fabrilabdesign/Yirra-docs/yirra_docs/docs/downloads.mdx

---
sidebar_position: 1
title: CAD Downloads
---

import { ModelViewer } from '@site/src/components/ModelViewer';
import DownloadGate from '@site/src/components/DownloadGate';

# CAD Downloads

Download all files needed to build your Replicant GEN 1 drone platform.

:::tip 🎯 First Time Builder?
**Skip the custom parts hunting** — Get our **Replicant Release Bundle** with all Yirra-manufactured components (carbon plates, battery, PMB, and fasteners) in one package. Off-the-shelf electronics sourced separately.

<a href="https://yirrasystems.com/product/prod_TqcqCXEB6vE8m6" target="_blank" rel="noopener noreferrer" style={{ display: 'inline-flex', alignItems: 'center', gap: '8px', padding: '10px 20px', backgroundColor: '#3b82f6', color: 'white', borderRadius: '8px', textDecoration: 'none', fontWeight: '500', marginTop: '8px' }}>
  🛒 View Release Bundle ($369 AUD)
</a>
:::

<ModelViewer
  modelPath="/files/3d-models/Replicant_Gen1.glb"
  title="Replicant GEN 1"
  description="Complete drone assembly"
  height="450px"
  showWireframeToggle={true}
  showFullscreenToggle={true}
  autoRotate={true}
/>

---

## Quick Downloads

Get everything you need in one click.

<div style={{ display: 'flex', gap: '16px', flexWrap: 'wrap', margin: '24px 0' }}>
  <DownloadGate file="/files/3d-printing/stl/Replicant_gen1_STL.zip" category="stl_zip" label="Download All STL Files (ZIP)" icon="📦" />
  <DownloadGate file="/files/STEP_Files/Replicant_gen1_STEP.zip" category="step_zip" label="Download All STEP Files (ZIP)" icon="📐" />
  <DownloadGate file="/files/3d-printing/stl/replicant_gen_1.stl" category="stl" label="Complete Assembly STL" icon="🖨️" />
  <DownloadGate file="/files/STEP_Files/Replicant_gen1.stp" category="step" label="Complete Assembly STEP" icon="📐" />
</div>

---

## 3MF project files

3MF packages with print settings, supports, and orientations (authored in Bambu Studio; import into PrusaSlicer, OrcaSlicer, or your slicer of choice). For printer guidance and ethics, see [3D Printing](/docs/3d-printing#equipment-considerations).

<table>
  <thead>
    <tr><th>Component</th><th>Description</th><th>Download</th></tr>
  </thead>
  <tbody>
    <tr>
      <td><strong>Chassis Core (Left USB)</strong></td>
      <td>Main structural component - USB port on left</td>
      <td><DownloadGate file="/files/3d-printing/3mf/Chassis_core_left_USB_modi.gcode.3mf" category="3mf" label="Download 3MF" icon="⬇" /></td>
    </tr>
    <tr>
      <td><strong>Chassis Core (Right USB)</strong></td>
      <td>Main structural component - USB port on right</td>
      <td><DownloadGate file="/files/3d-printing/3mf/Chassis_core_right_USB_modi.gcode.3mf" category="3mf" label="Download 3MF" icon="⬇" /></td>
    </tr>
    <tr>
      <td><strong>Arm Bosses</strong></td>
      <td>All four arm mounting interfaces</td>
      <td><DownloadGate file="/files/3d-printing/3mf/Arm_bosses.gcode.3mf" category="3mf" label="Download 3MF" icon="⬇" /></td>
    </tr>
    <tr>
      <td><strong>Motor Mounts</strong></td>
      <td>High-strength motor mounting brackets</td>
      <td><DownloadGate file="/files/3d-printing/3mf/Motor_mounts.gcode.3mf" category="3mf" label="Download 3MF" icon="⬇" /></td>
    </tr>
    <tr>
      <td><strong>Nose Cone 04 Mount</strong></td>
      <td>Camera and antenna mounting component</td>
      <td><DownloadGate file="/files/3d-printing/3mf/Nose_cone_04_mount.gcode.3mf" category="3mf" label="Download 3MF" icon="⬇" /></td>
    </tr>
    <tr>
      <td><strong>Battery Rail Male</strong></td>
      <td>Battery mounting rail component</td>
      <td><DownloadGate file="/files/3d-printing/3mf/Battery_rail_male.gcode.3mf" category="3mf" label="Download 3MF" icon="⬇" /></td>
    </tr>
  </tbody>
</table>

---

## Individual Component Files

Need specific parts? Expand the sections below to download individual components.

<details>
<summary><strong>STEP Files (Editable CAD)</strong></summary>

Full parametric models for CAD modification and custom adaptations.

<table>
  <thead><tr><th>Component</th><th>Download</th></tr></thead>
  <tbody>
    <tr><td>Chassis Core Left USB</td><td><DownloadGate file="/files/STEP_Files/chassis_core_left_usb.stp" category="step" label="Download STEP" icon="⬇" /></td></tr>
    <tr><td>Chassis Core Right USB</td><td><DownloadGate file="/files/STEP_Files/chassis_core_right_usb.stp" category="step" label="Download STEP" icon="⬇" /></td></tr>
    <tr><td>Motor Mount</td><td><DownloadGate file="/files/STEP_Files/Motor_mount.stp" category="step" label="Download STEP" icon="⬇" /></td></tr>
    <tr><td>Battery Rail Male</td><td><DownloadGate file="/files/STEP_Files/battery_rail_male.stp" category="step" label="Download STEP" icon="⬇" /></td></tr>
    <tr><td>Front Left Arm Boss</td><td><DownloadGate file="/files/STEP_Files/Left_front_arm_boss.stp" category="step" label="Download STEP" icon="⬇" /></td></tr>
    <tr><td>Front Right Arm Boss</td><td><DownloadGate file="/files/STEP_Files/Right_front_arm_boss.stp" category="step" label="Download STEP" icon="⬇" /></td></tr>
    <tr><td>Rear Left Arm Boss</td><td><DownloadGate file="/files/STEP_Files/Left_rear_arm_boss.stp" category="step" label="Download STEP" icon="⬇" /></td></tr>
    <tr><td>Rear Right Arm Boss</td><td><DownloadGate file="/files/STEP_Files/Right_rear_arm_boss.stp" category="step" label="Download STEP" icon="⬇" /></td></tr>
    <tr><td>Upper Shell</td><td><DownloadGate file="/files/STEP_Files/upper_shell.stp" category="step" label="Download STEP" icon="⬇" /></td></tr>
    <tr><td>04cm Component</td><td><DownloadGate file="/files/STEP_Files/04cm.stp" category="step" label="Download STEP" icon="⬇" /></td></tr>
    <tr><td>Spine</td><td><DownloadGate file="/files/STEP_Files/spine.stp" category="step" label="Download STEP" icon="⬇" /></td></tr>
    <tr><td>Top Plate Brace</td><td><DownloadGate file="/files/STEP_Files/top_plate_brace.stp" category="step" label="Download STEP" icon="⬇" /></td></tr>
    <tr><td>Bottom Plate</td><td><DownloadGate file="/files/STEP_Files/bottom_plate.stp" category="step" label="Download STEP" icon="⬇" /></td></tr>
  </tbody>
</table>

</details>

<details>
<summary><strong>STL Files (Mesh for Slicers)</strong></summary>

Mesh files for 3D printing with any slicer software.

<table>
  <thead><tr><th>Component</th><th>Download</th></tr></thead>
  <tbody>
    <tr><td>Chassis Core Left USB</td><td><DownloadGate file="/files/3d-printing/stl/chassis_core_left_usb.stl" category="stl" label="Download STL" icon="⬇" /></td></tr>
    <tr><td>Chassis Core Right USB</td><td><DownloadGate file="/files/3d-printing/stl/chassis_core_right_usb.stl" category="stl" label="Download STL" icon="⬇" /></td></tr>
    <tr><td>Motor Mounts</td><td><DownloadGate file="/files/3d-printing/stl/motor_mounts.stl" category="stl" label="Download STL" icon="⬇" /></td></tr>
    <tr><td>Left Front Arm Boss</td><td><DownloadGate file="/files/3d-printing/stl/left_front_armboss.stl" category="stl" label="Download STL" icon="⬇" /></td></tr>
    <tr><td>Right Front Arm Boss</td><td><DownloadGate file="/files/3d-printing/stl/right_front_arm_boss.stl" category="stl" label="Download STL" icon="⬇" /></td></tr>
    <tr><td>Left Rear Arm Boss</td><td><DownloadGate file="/files/3d-printing/stl/left_rear_arm_boss.stl" category="stl" label="Download STL" icon="⬇" /></td></tr>
    <tr><td>Right Rear Arm Boss</td><td><DownloadGate file="/files/3d-printing/stl/right_rear_arm_boss.stl" category="stl" label="Download STL" icon="⬇" /></td></tr>
    <tr><td>Battery Rail Male</td><td><DownloadGate file="/files/3d-printing/stl/battery_rail_male.stl" category="stl" label="Download STL" icon="⬇" /></td></tr>
    <tr><td>Upper Shell</td><td><DownloadGate file="/files/3d-printing/stl/upper_shell.stl" category="stl" label="Download STL" icon="⬇" /></td></tr>
    <tr><td>Spine</td><td><DownloadGate file="/files/3d-printing/stl/spine.stl" category="stl" label="Download STL" icon="⬇" /></td></tr>
    <tr><td>Top Plate Brace</td><td><DownloadGate file="/files/3d-printing/stl/top_plate_brace.stl" category="stl" label="Download STL" icon="⬇" /></td></tr>
    <tr><td>Bottom Plate</td><td><DownloadGate file="/files/3d-printing/stl/bottom_plate.stl" category="stl" label="Download STL" icon="⬇" /></td></tr>
    <tr><td>04cm Mount</td><td><DownloadGate file="/files/3d-printing/stl/04cm.stl" category="stl" label="Download STL" icon="⬇" /></td></tr>
  </tbody>
</table>

</details>

---

## Revision History

<div style={{ fontFamily: 'ui-monospace, SFMono-Regular, Menlo, Monaco, Consolas, monospace', fontSize: '13px' }}>

<div style={{ border: '1px solid #4b5563' }}>
  <div style={{ backgroundColor: '#1f2937', color: '#f9fafb', padding: '10px 14px', display: 'flex', justifyContent: 'space-between', alignItems: 'center' }}>
    <span style={{ fontWeight: '600', letterSpacing: '0.5px' }}>REV 1.0.0</span>
    <span style={{ color: '#d1d5db' }}>2026-01-22</span>
  </div>
  <div style={{ padding: '14px', backgroundColor: '#111827' }}>
    <div style={{ display: 'grid', gridTemplateColumns: '70px 1fr', gap: '6px 12px', lineHeight: '1.7' }}>
      <span style={{ color: '#34d399', fontWeight: '600' }}>[INIT]</span><span style={{ color: '#e5e7eb' }}>Initial release — Replicant GEN 1 CAD package</span>
      <span style={{ color: '#9ca3af', fontWeight: '500' }}>[INC]</span><span style={{ color: '#d1d5db' }}>3MF print projects (import/migrate settings to your slicer)</span>
      <span style={{ color: '#9ca3af', fontWeight: '500' }}>[INC]</span><span style={{ color: '#d1d5db' }}>STEP files for CAD modification and custom adaptations</span>
      <span style={{ color: '#9ca3af', fontWeight: '500' }}>[INC]</span><span style={{ color: '#d1d5db' }}>STL mesh files for all printable components</span>
      <span style={{ color: '#9ca3af', fontWeight: '500' }}>[INC]</span><span style={{ color: '#d1d5db' }}>Left/Right USB chassis variants</span>
    </div>
  </div>
</div>

</div>

:::info Revision Control
Files follow semantic versioning. Check back for updates after major revisions.
:::

---

## Next Steps

1. [Parts List](/docs/bom) - Get electronics and carbon fiber
2. [3D Printing](/docs/3d-printing) - Proper material handling
3. [Arm Bonding](/docs/arm-bonding) - Start assembly
