fabrilabdesign/Yirra-docs/yirra_docs/docs/platform.md

---
sidebar_position: 1
title: Platform Overview
---

import ImageToggle from '@site/src/components/ImageToggle';
import SupplementalLipoBracketCta from '@site/src/components/SupplementalLipoBracketCta';
import CommercialProgramsPipeline from '@site/src/components/CommercialProgramsPipeline';

# Replicant GEN 1 Platform

Replicant GEN 1 is a long-range FPV platform built around true 3D structural design: carbon-fiber tubes for arm stiffness, volumetric 3D-printed nodes for real load paths, and an enclosed aerodynamic chassis that treats packaging as part of performance. The result is a lighter, stiffer airframe with cleaner airflow, protected electronics, rapid battery swaps, and footage-first vibration control — designed for builders.

---

## Highlights

- **True 3D tubular arms** → truss-level rigidity with cleaner aerodynamics
- **Rail-mounted battery** → fast, repeatable swaps + mass damping for stable footage
- **Intelligent power button + full enclosure** → safer, cleaner operation with protected internals

<picture>
  <source
    type="image/webp"
    srcSet="/img/hero/new_hero_800.webp 800w, /img/hero/new_hero_1200.webp 1200w, /img/hero/new_hero_2400.webp 2400w"
    sizes="(max-width: 800px) 100vw, (max-width: 1400px) 90vw, 1400px"
  />
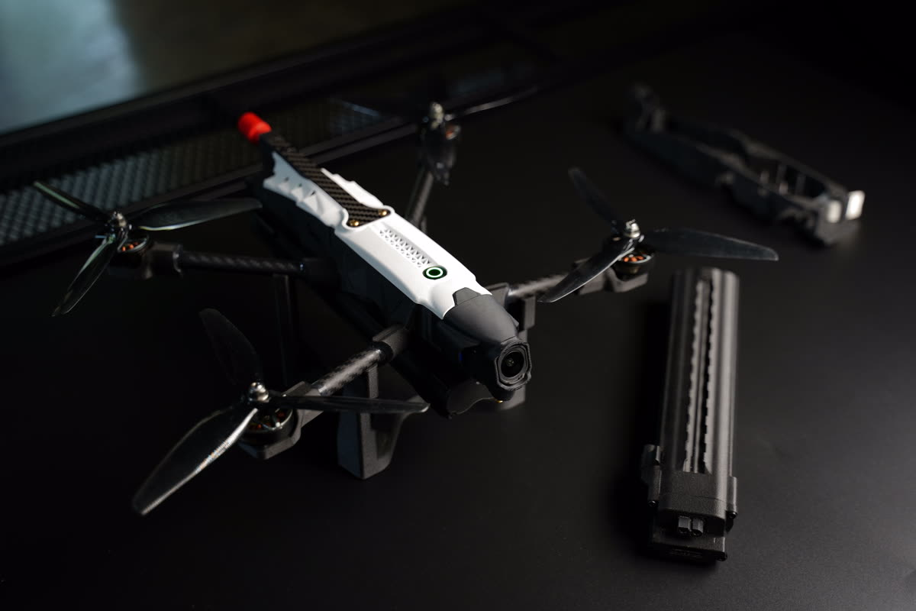
[picture p1: yirra_docs/static/img/hero/new_hero_1200.jpg]
Replicant GEN 1 Platform
  
</picture>

---

## Competitive Positioning

This isn't a bando basher or a 3" proximity rig designed for constant concrete abuse. Replicant is designed to compete against long-range truss-style platforms and larger cine-class flat-plate frames — while reducing drag, improving protection, and cleaning up the overall build and operator workflow.

<div style={{ display: 'grid', gridTemplateColumns: 'repeat(auto-fit, minmax(300px, 1fr))', gap: '20px', margin: '24px 0' }}>
  <div>
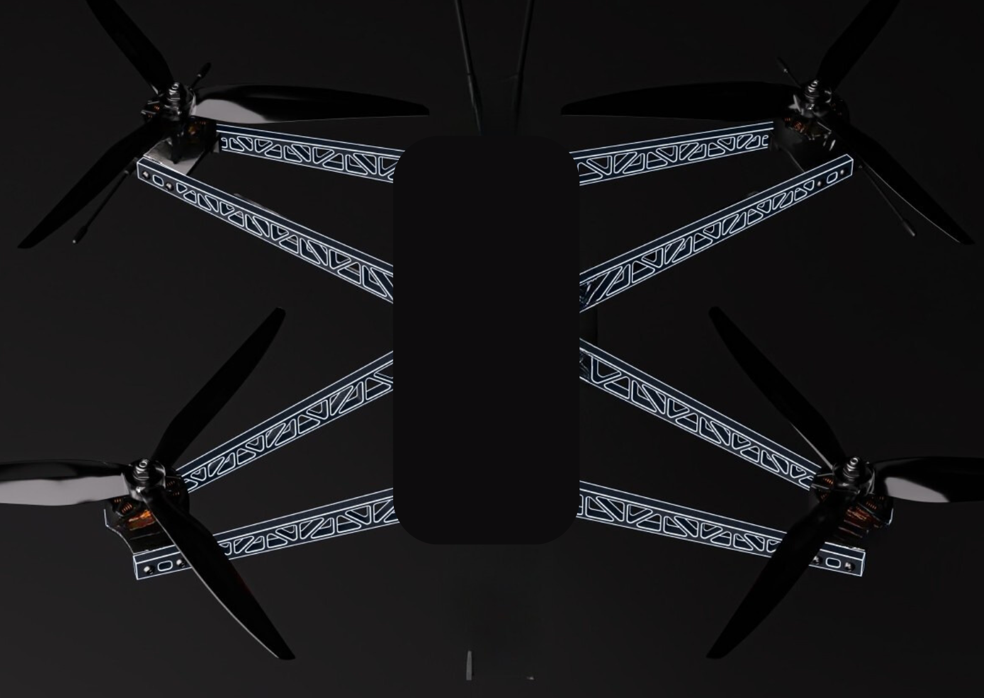
[picture p2: yirra_docs/static/img/Competitor_drones/Untitled design (4).png]
Traditional truss frame design
    
    <p style={{ textAlign: 'center', margin: '8px 0', fontSize: '0.9em', color: '#666' }}>Truss Frame: 2.5D flat plate with cutouts</p>
  </div>
  <div>
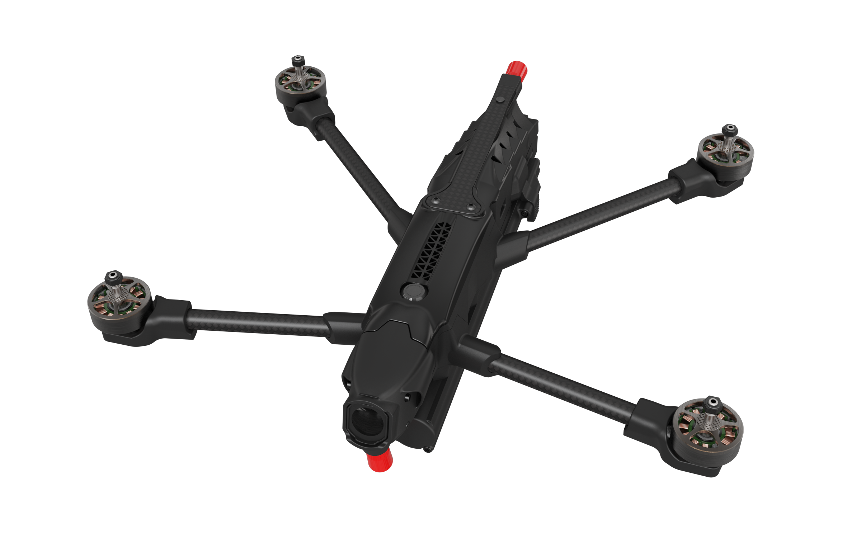
[picture p3: yirra_docs/static/img/Drone_updates/Hero_iso2.png]
Replicant tubular arm design
    
    <p style={{ textAlign: 'center', margin: '8px 0', fontSize: '0.9em', color: '#666' }}>Replicant: True 3D volumetric structure</p>
  </div>
</div>

| Attribute | Replicant GEN 1 | Truss Frames | Bando Basher |
|---|---|---|---|
| Aerodynamics | Excellent (tubular arms, clean surfaces) | Often compromised (flat plate arms) | Not the focus |
| Arm Stiffness | Excellent (CF tubes + structural nodes) | Excellent (long plates) | Moderate |
| Crash Robustness | Good | Good | Excellent |
| Weight Efficiency | Excellent | Moderate | Moderate |

**Takeaway:** Replicant aims for truss-level arm stiffness with significantly cleaner aerodynamics — no flat plates creating turbulence and drag.

---

## Who This Drone Is For

Anyone who wants a high-performance long-range platform — and is willing to build it properly.

Replicant is open-source for builders: download it, print it, build it, repair it, and modify it. (Details on what's open vs not are covered later.)

### Prop Size Flexibility

The tubular arm design accommodates multiple prop sizes, each delivering distinct flight characteristics:

| Prop Size | Character | Best For |
|---|---|---|
| **6"** | Highly maneuverable, fast acceleration, low rotational inertia | Aggressive flying, tighter spaces |
| **7"** | Balanced performance (design target) | General long-range, cinematic work |
| **8"** | Efficient, low disk loading, extended range | Maximum endurance, smooth cruising |

You could run 5" if you really wanted — but Replicant is optimized around 7–8" long-range use.

**Replicant competes against:**
- Traditional 7" long-range frames
- Larger cine-class truss / flat-plate designs

Replicant in 7" configuration

---

## Builder Requirements & Expectations

This isn't bind-and-fly. You're building it yourself — which means you get performance, repairability, and control… and you also take responsibility for fitment and assembly.

### Equipment Needed
- FDM 3D printer capable of CF-Nylon (or equivalent engineering filament)
- SLA printer for the top cover (or alternate fabrication route if you offer one)
- Standard drone building tools (hex drivers, soldering gear, threadlock; calipers helpful)

### Stack Constraints

The chassis supports common stack footprints, but it's designed around compact packaging and proven ESC options.

| Component | Recommendation |
|---|---|
| Flight Controller | Open choice — compatible with common 20x20 or 30x30 footprints |
| ESC | iFlight Borg Mini (stack) or iFlight BLITZ E55S / E55 (55A class) |
| GPS | MATEK M10-5883 (or similar class) |

If you have the skills, tools, and patience to build your own drone, Replicant delivers performance that competes with — and in some respects exceeds — many commercial alternatives.

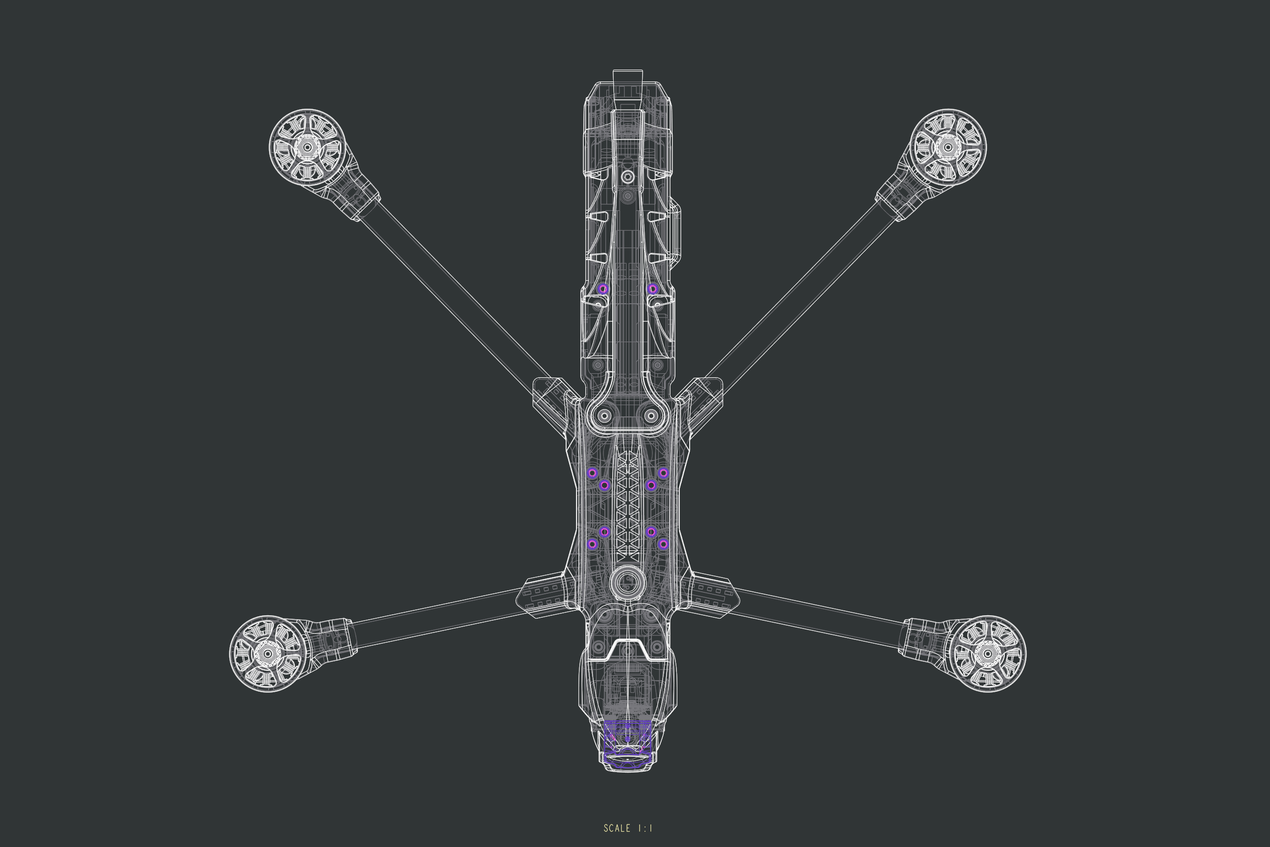
[picture p4: yirra_docs/static/img/Drone_updates/Xray.png]
Electronics bay installation view


---

## Flight Dynamics Preview: Mass Distribution

Replicant's geometry produces distinct flight characteristics through deliberate mass placement.

**Roll axis — compact inertia:** the 6S cell arrangement concentrates mass near the roll axis. Combined with lightweight carbon arms and printed motor mounts, this delivers snappy roll response with low rotational inertia.

**Pitch axis — extended inertia:** the elongated battery runs fore-aft, increasing pitch inertia. That isn't a drawback — it adds stability in forward flight and smooth pitch transitions for cinematic work.

### Why this matters
- **Roll:** quick direction changes, responsive to stick input
- **Pitch:** damped oscillation, stable in cruise, predictable accel/decel
- **Yaw:** balanced by symmetric arm geometry

This mass distribution is optimized for long-range cruising and cinematic flight, not freestyle acrobatics.

---

## Blackbox Logs: Real-World Performance Data

Download these blackbox logs to analyze flight performance, tuning, and noise characteristics in Betaflight Blackbox Explorer or PIDtoolbox:

### 100% Throttle Ramps
- [📊 Flight Log A](/files/Black_box_log/Replicant_Gen_1.BBL)
- [📊 Flight Log B](/files/Black_box_log/Replicant_Gen_1_b.BBL)
- [📊 Flight Log C](/files/Black_box_log/Replicant_Gen_1_c.BBL)
- [📊 Flight Log D](/files/Black_box_log/Replicant_Gen_1_d.BBL)
- [📊 Flight Log E](/files/Black_box_log/Replicant_Gen_1_e.BBL)
- [📊 Flight Log F](/files/Black_box_log/Replicant_Gen_1_f.BBL)
- [📊 Flight Log G](/files/Black_box_log/Replicant_Gen_1_g.BBL)

### Hover Logs
- [🎯 Hover Log A](/files/Black_box_log/Replicant_Gen_1_hover.BBL)
- [🎯 Hover Log B](/files/Black_box_log/Replicant_Gen_1_hover_b.BBL)
- [🎯 Hover Log C](/files/Black_box_log/Replicant_Gen_1_hover_c.BBL)

### 6 Inch Prop Performance Logs
- [🔹 6" Prop Log A](/files/Black_box_log/6_inch.BBL)
- [🔹 6" Prop Log B](/files/Black_box_log/6_inch_b.BBL)
- [🔹 6" Prop Log C](/files/Black_box_log/6_inch_c.BBL)
- [🔹 6" Prop Log D](/files/Black_box_log/6_inch_d.BBL)
- [🔹 6" Prop Log E](/files/Black_box_log/6_inch_e.BBL)
- [🔹 6" Prop Log F](/files/Black_box_log/6_inch_f.BBL)
- [🔹 6" Prop Log G](/files/Black_box_log/6_inch_g.BBL)

This is an example of the kind of noise performance you can expect from a well-built drone—but it's not a "Goldilocks" perfect-case build. This blackbox log came from a quad with one slightly gravelly motor and relatively new, but loosely fitting, 7-inch props. With fresh motors and tighter-fitting props, the noise performance would likely improve further.

---

## Why Redesign the Drone?

FPV drone design has remained largely unchanged since the early 2000s, relying on basic materials and assembly methods. While consumer drones have advanced significantly with sophisticated features and user-friendly designs, the FPV community has been underserved by comparison.

With the huge strides in 3D printing and other manufacturing enablement technologies, and broad uptake of these technologies in the builder community, that needn't be the case.

**The Replicant breaks this mold by:**
- Leveraging modern manufacturing techniques for superior performance
- Prioritizing builder accessibility and repairability
- Delivering professional-grade flight characteristics
- Maintaining open-source philosophy for community advancement

---

## The Catalyst: Intelligent Power Control

Replicant drone on button detail

The Replicant is one of the only drones available today with a dedicated arm/disarm button. We use a microcontroller to provide intelligent button behavior: press and hold for 2 seconds to arm/turn on, shorter hold to disarm/turn off. This prevents accidental disarming during flight while providing tactile feedback for reliable operation.

---

## Rail-Mounted Modular Battery System

Eliminate velcro strap fiddliness with our rail-mounted modular battery system, built with the operator in mind. It allows for rapid, effortless battery swaps while the battery's mass and rigidity enhance flight characteristics and damp vibrations that could otherwise cause jello in your footage.

<div style={{ display: 'grid', gridTemplateColumns: 'repeat(auto-fit, minmax(300px, 1fr))', gap: '20px', margin: '24px 0' }}>
  <div>
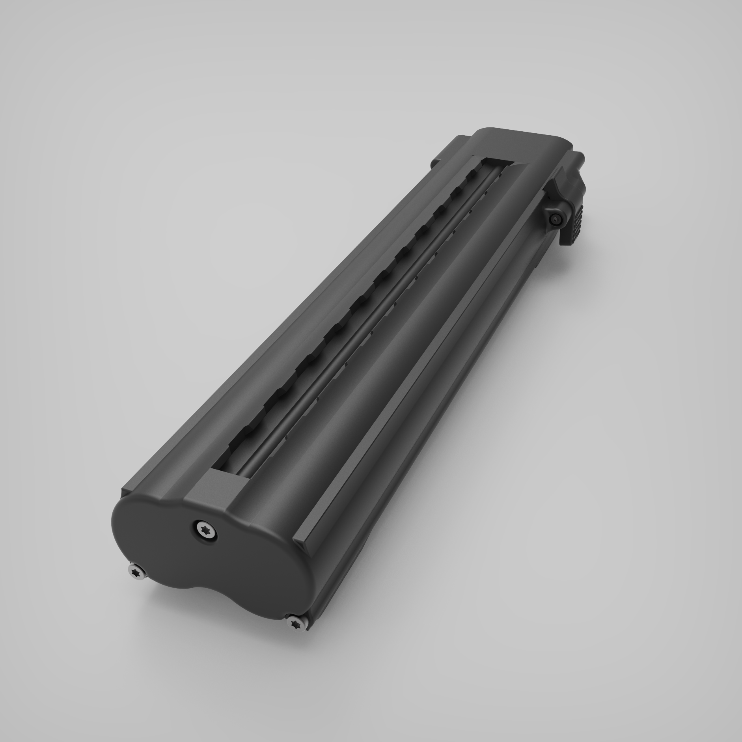
[picture p5: yirra_docs/static/img/drone/Battreryfront_iso.png]
Battery front isometric view
    
    <p style={{ textAlign: 'center', margin: '8px 0', fontSize: '0.9em', color: '#666' }}>Front isometric view</p>
  </div>
  <div>
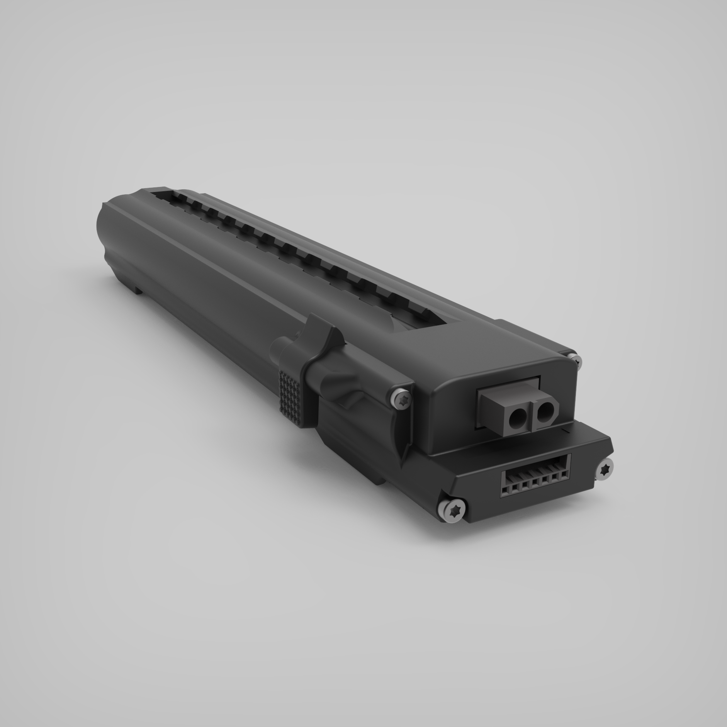
[picture p6: yirra_docs/static/img/drone/battery_connector_iso.png]
Battery connector detail
    
    <p style={{ textAlign: 'center', margin: '8px 0', fontSize: '0.9em', color: '#666' }}>Connector detail</p>
  </div>
</div>

<SupplementalLipoBracketCta />

<CommercialProgramsPipeline />

### Rapid Battery Swaps: Professional Performance

Our rail-mounted battery system provides secure mounting with rapid swap capability, designed for professional operation where reliability and speed matter.

Battery removal animation

**Battery Specifications:**
- **Cells:** Eve 50 PL in 6S1P configuration
- **Capacity:** 5000mAh per pack
- **Mounting:** Rail-based system for rapid, secure swaps
- **Design:** Single pack configuration optimized for current build

---

## Vibration Mitigation from Day 1

Our nose cone is entirely TPU, effectively isolating normal drone noise, resulting in clean, clear, jello-free footage.

TPE nose cone vibration isolation

**Vibration Control Features:**
- TPU nose cone for acoustic isolation
- Battery mass damping for reduced vibrations
- Carbon fiber construction for rigidity

---

## Aerodynamic Design: Efficiency Through Form

If it flies, it better be aerodynamic. This is not hard, people. The Replicant achieves optimal efficiency through:

- **Tubular arms** for minimal drag
- **Smooth uncluttered top surface** for laminar flow
- **Cutaway exospine** for reduced frontal area
- **Underslung battery system** for balanced weight distribution

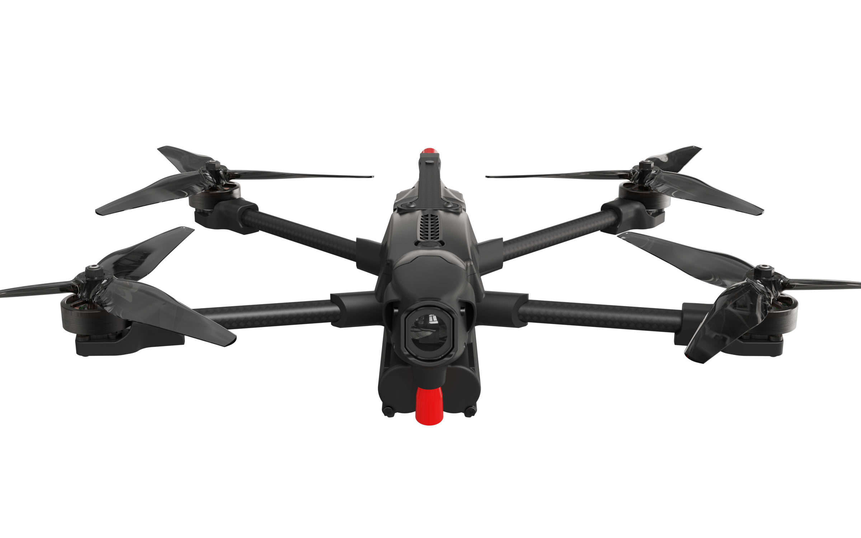
[picture p7: yirra_docs/static/img/Drone_updates/Low Frontal area = low drag.png]
Aerodynamic Replicant drone design


### Aerodynamic Improvements

The Replicant GEN 1 features several aerodynamic optimizations designed to reduce drag, improve cooling, and enhance overall flight performance.

#### Front Cooling Duct

The front cooling duct optimizes airflow through the electronics bay, providing efficient cooling while maintaining aerodynamic efficiency.

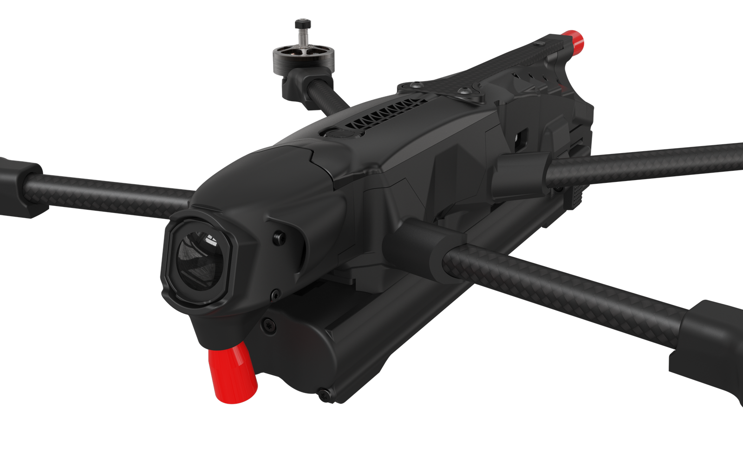
[picture p8: yirra_docs/static/img/Drone_updates/Front cooling duct .png]
Front cooling duct for optimized airflow


#### Stack Ventilation System

The flight controller and ESC stack features both upper and lower ventilation ports for optimal cooling air flow through the electronics bay.

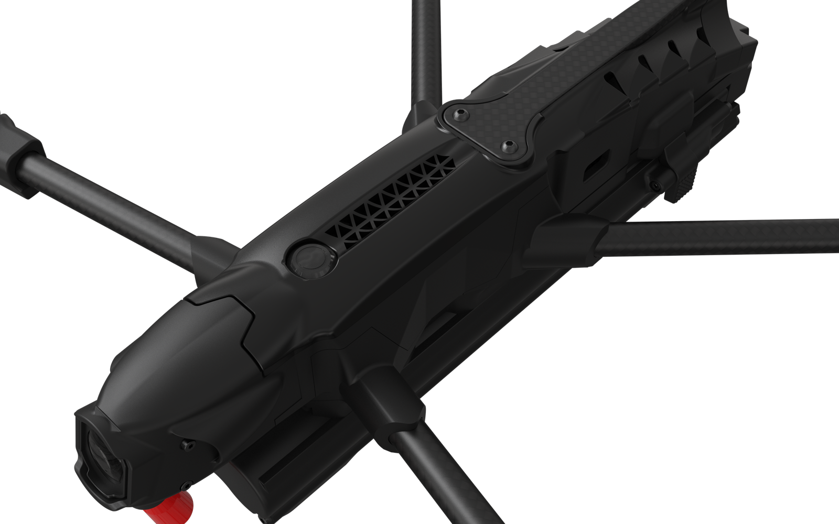
[picture p9: yirra_docs/static/img/Drone_updates/Upper_stack vent.png]
Upper stack ventilation for electronics cooling


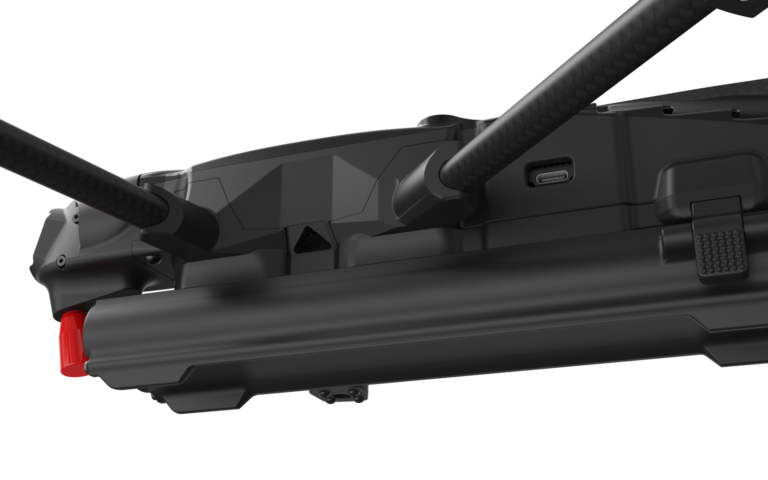
[picture p10: yirra_docs/static/img/Drone_updates/Lower stack vent.png]
Lower stack ventilation for heat dissipation


#### Dorsal Venturi Ducts

These are the dorsal venturi ducts and they forcefully ventilate the stack and O4 Pro during forward flight. They also materially impact a reduction in frontal and wetted area further reducing parasitic losses.

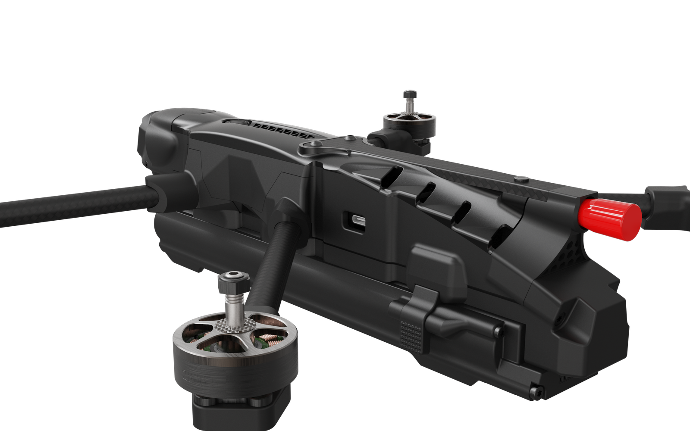
[picture p11: yirra_docs/static/img/Drone_updates/Dorsal vents.png]
Dorsal venturi ducts for enhanced ventilation and reduced drag


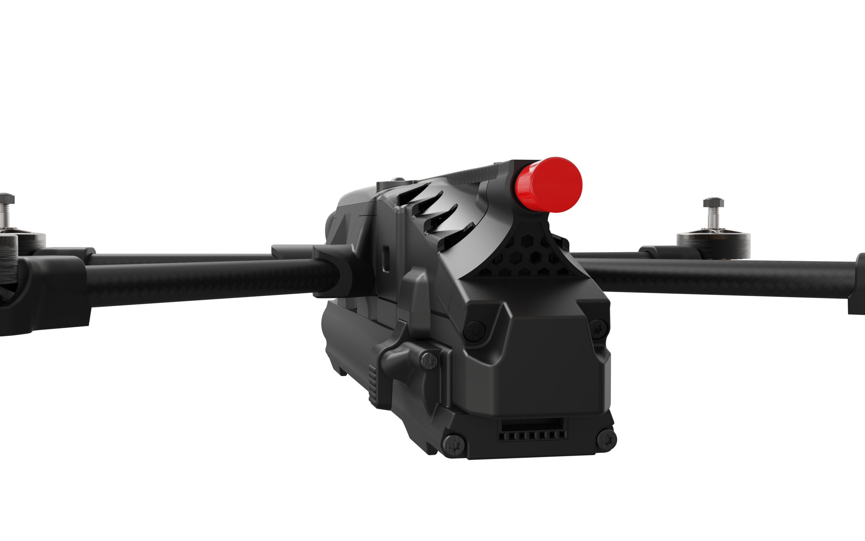
[picture p12: yirra_docs/static/img/Drone_updates/Dorsal vent 2.png]
Additional dorsal venturi duct detail


These aerodynamic improvements work together to reduce parasitic drag, enhance cooling efficiency, and improve overall flight performance.

---

## Strategic Construction: Strength Where Necessary

We're not married to any particular construction technique. That's why we've used printed components strategically in conjunction with the high specific strength of carbon plates and tubes to achieve the best of both worlds.

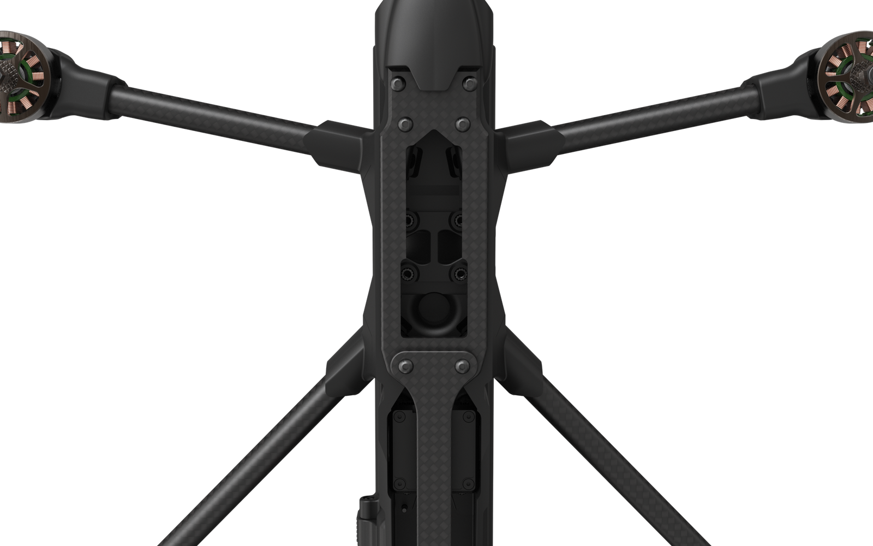
[picture p13: yirra_docs/static/img/Drone_updates/Carbon where it counts.png]
Hybrid construction materials


**Construction Philosophy:**
- **Carbon Fiber Plates:** High strength-to-weight ratio for structural integrity
- **CF-Nylon Printed Parts:** Optimized for complex geometries and assembly
- **Carbon Tubes:** Superior stiffness for arm construction
- **Modular Design:** Easy maintenance and upgrades

---

## Fully Enclosed Electronics Protection

We're doing away with janky and half-baked exposed internal electronics. We engineered a fully enclosed chassis that protects your drone's delicate and expensive internals, while the tubular arms serve as ideal protective conduits for the motor wiring harness.

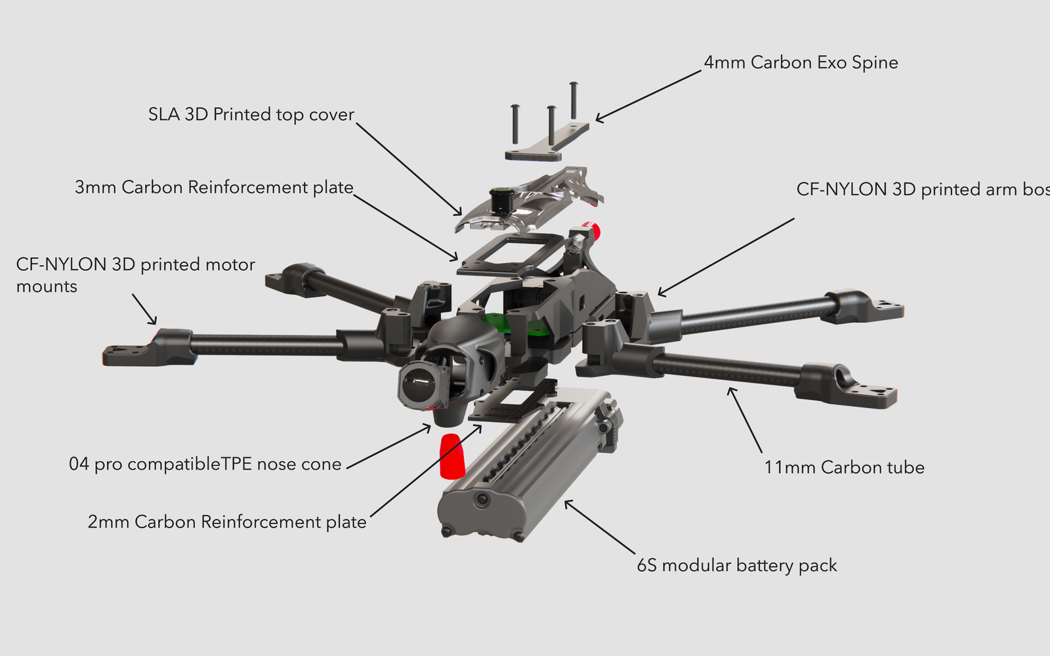
[picture p14: yirra_docs/static/img/drone/annotated_explode.PNG]
Fully enclosed chassis design


---

## Optimized Antenna Placement

This drone doesn't wear bunny ears—we're changing how drones are packaged and antennas don't escape. We've placed dual Cavalry 2.4 and 5.8GHz antennas on each end of the drone. This was simple, obvious packing optimization spotted during the design phase.

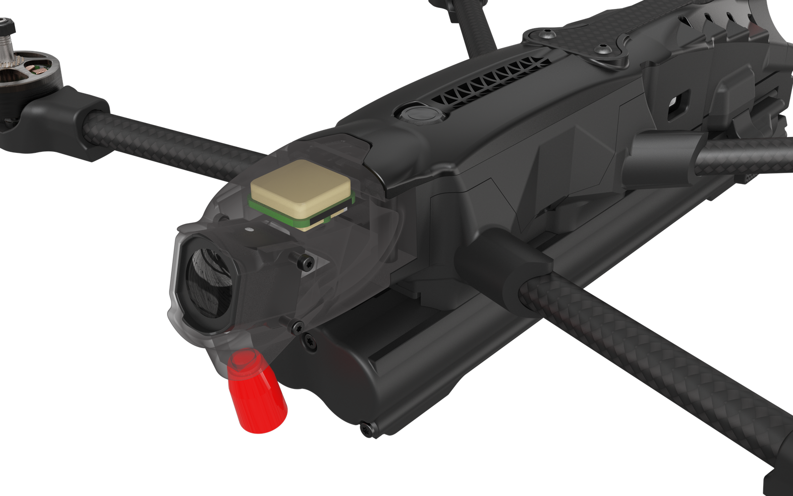
[picture p15: yirra_docs/static/img/Drone_updates/GPS_XRAY.png]
Integrated antenna design


---

## Superior GPS Performance

Few other drones physically isolate the GPS better than ours. With our underslung battery and uncluttered top surface, we provide unimpeded sky access and below-average EMI exposure. The result? Fast satellite acquisition and reliable GPS performance.

**GPS Performance:**
- 25-30 satellites typically visible
- Reduced Satellite acquisition time
- Ceramic GPS antenna is shielded from damage inside the nose cone
- Minimal EMI interference
- Optimal sky visibility

---

## Open Source Airframe, Professional Power System

If you crash a drone, the most likely thing you're going to break is your ego. A close second is a drone arm. We want to keep you flying, so we're open-sourcing the Replicant airframe — print it, mod it, fix it.

**What's Open Source:**
- **Complete CAD files** (STEP/3MF) for all 3D printed components
- **DXF files** for carbon fiber plates — cut your own or buy ours
- **Full fastener specifications** — source yourself or buy our kit
- **TPU flexible parts** for vibration dampening
- **Comprehensive build guides** with videos and detailed instructions

**What's Not Open Source:**
- **Battery Pack** — Proprietary design using spot-welded Eve 50 PL cells. We don't release these files for safety reasons — improper cell handling is a fire/injury risk.
- **Power Management Board** — Closed source hardware and firmware. This is our secret sauce for the intelligent arm/disarm behavior and includes safety-critical voltage monitoring.

This isn't about gatekeeping — it's about keeping you safe and keeping the lights on.

**Repair & Modify Freely:**
- Fabricate replacement parts on your 3D printer
- Modify the frame for custom payloads or configurations
- Build entirely new drone variants from the ground up
- Community-driven development and enhancements

---

## Platform Benefits Summary

**For Builders:**
- Create your own drone frame at home
- Repair damaged drones without ordering parts online
- Customize and optimize for specific applications
- Access to professional-grade flight characteristics

**For Pilots:**
- Reliable, consistent flight performance
- Easy maintenance and upgrades
- Superior video quality with vibration mitigation
- Professional-grade build quality

**For the Community:**
- Open-source design philosophy
- Advanced manufacturing techniques accessible to builders
- Foundation for future drone platform development
- Educational resource for FPV technology

---

## Next Steps

1. [Download CAD Files](/docs/downloads) - Get started with the Replicant platform
2. [Review BOM](/docs/bom) - Understand component requirements
3. [Begin Assembly](/docs/assembly) - Start building your Replicant
