fabrilabdesign/Yirra-docs/yirra_docs/docs/arm-bonding.md

---
sidebar_position: 4
title: Arm Bonding
---

# Arm Bonding

The most critical step in your build. Each arm is a carbon tube bonded between a motor mount and arm boss using 3M Scotch-Weld DP-490 structural epoxy.

Properly assembled arm

:::info Engineered interfaces provide positional accuracy, control joint flow and keying for torsional strength
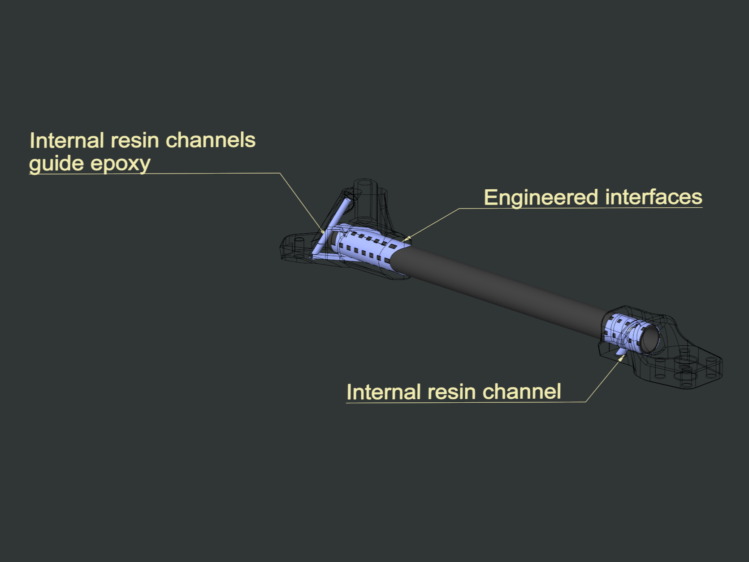
[picture p16: yirra_docs/static/img/arm_bonding/Resin channel annotation.png]
Resin channel annotation

:::

---

## What You Need

| Item | Notes |
|---|---|
| 3M Scotch-Weld DP-490 Epoxy | Structural adhesive with applicator gun |
| Carbon tubes | 11mm OD, cut to length |
| Cutting jig | Precision cutting tool for carbon tubes |
| Motor mounts | 4x printed in CF-Nylon |
| Arm bosses | 4x printed in CF-Nylon |
| Acetone | Surface prep (preferred) — isopropyl also works |
| Mixing nozzles | Included with DP-490 |
| Spacer block | For alignment (printed or scrap) |

### Arm Cutting Jig

This precision jig ensures accurate carbon tube lengths for perfect arm assembly. While the jig improves cutting accuracy and consistency, measuring and cutting by hand is sufficient if you prefer not to print it.

Carbon tube cutting jig

[📁 Download Cutting Jig STEP File](/img/tools/cj2.stp)

### Carbon Tube Lengths

Different drone platforms require different arm lengths. Use the appropriate lengths for your platform:

| Platform | Component | Qty | Front Arm Length | Rear Arm Length |
|---|---|-----|---|---|
| 6 inch | Carbon Tubes | 4 | 93mm | 118mm |
| 7 inch | Carbon Tubes | 4 | 105mm | 134mm |
| 8 inch | Carbon Tubes | 4 | 133mm | 157mm |

:::info Platform Selection
Choose the correct arm lengths based on your motor-propeller combination and desired flight characteristics. The 6-inch platform is more compact and maneuverable, while the 7-inch platform offers better stability and payload capacity.
:::

### The Epoxy System

We use 3M Scotch-Weld DP-490 structural epoxy applied with a manual applicator gun. This two-part adhesive provides exceptional bond strength for carbon-to-nylon joints.

Scotch-Weld DP-490 epoxy cartridge

Manual applicator gun for DP-490

:::tip Alternative Epoxies
If you can't source DP-490, these 2-part structural epoxies also work well:
- Gorilla 2-Part Epoxy
- Pattex Epoxy
- UHU Plus
- Loctite Epoxy

Any quality 2-part epoxy with good adhesion to plastics and composites will work. Avoid quick-set formulas — you need working time for alignment.
:::

---

## Process

### 1. Small Batches

Work on **1-2 arms at a time**.

Alignment is more important than speed. DP-490 gives you approximately 90 minutes of working time, but don't rush—get each arm right before moving on.

---

### 2. Surface Prep

- Scuff bond areas with 120-grit sandpaper
- Clean all surfaces with acetone (preferred) or isopropyl alcohol
- Let dry completely

---

### 3. Epoxy Injection System

The CF-Nylon motor mounts feature **internal injection ports** that perfectly distribute epoxy around the carbon tube. This design ensures complete, void-free coverage of the bond surface.

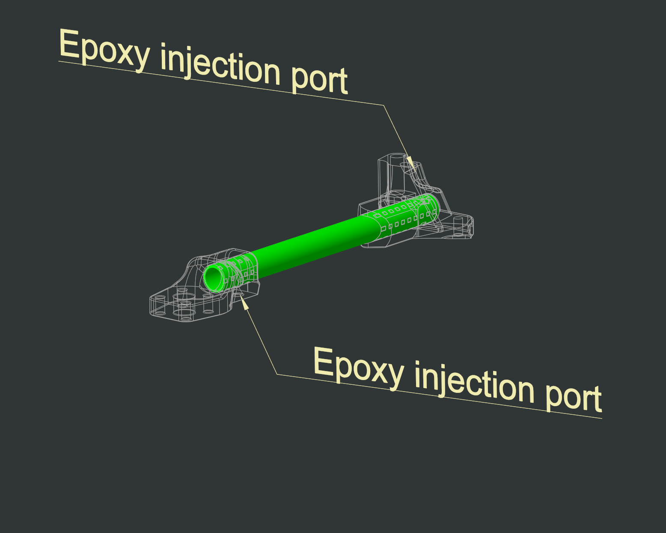
[picture p17: yirra_docs/static/img/arm_bonding/Epoxy injection port.png]
Internal injection port in the motor mount


#### Injection Process

1. Insert the carbon tube into the motor mount socket until seated
2. Attach the mixing nozzle to your DP-490 cartridge
3. Insert the nozzle tip into the injection port
4. Slowly inject epoxy until you see it appear at the opposite end

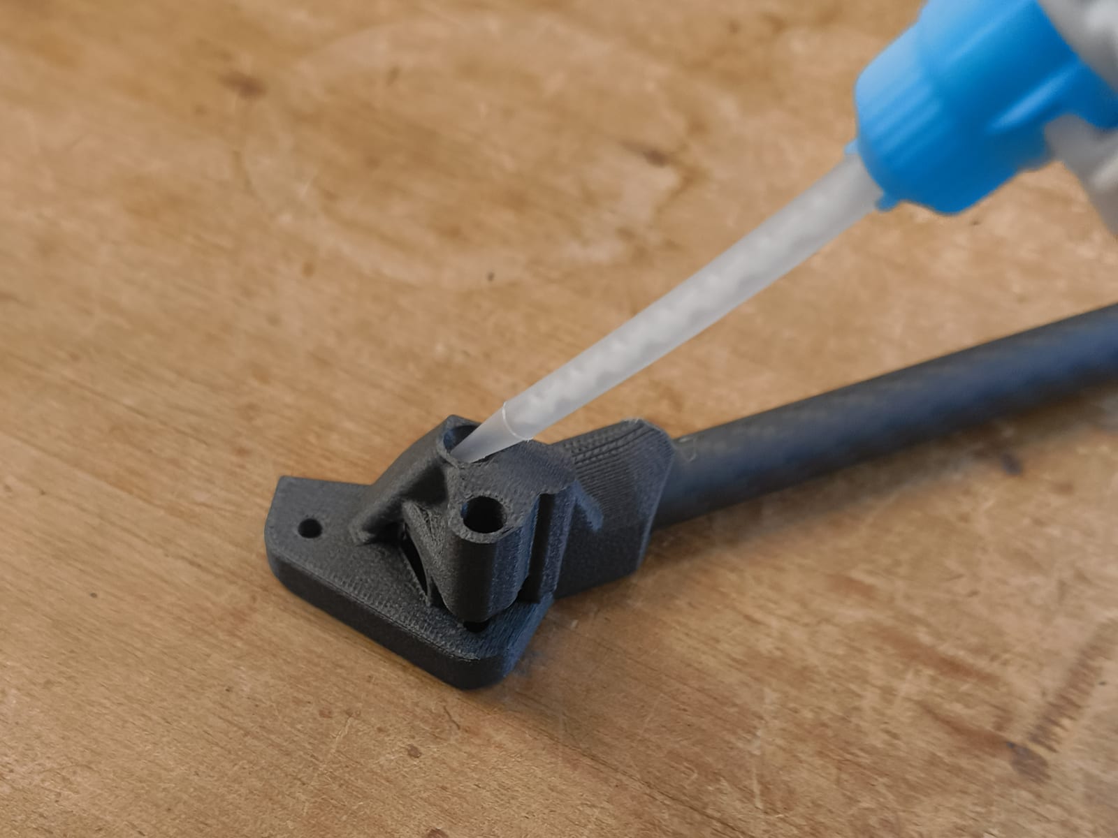
[picture p18: yirra_docs/static/img/arm_bonding/Epoxy_injection.jpg]
Epoxy being injected through the internal port


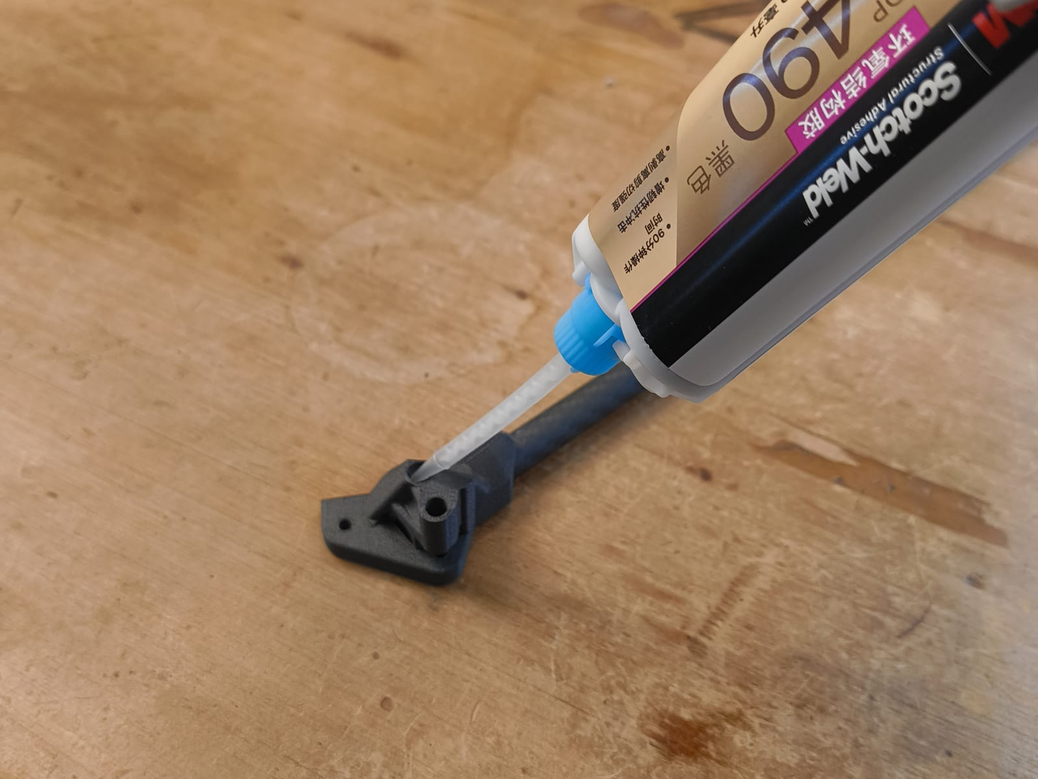
[picture p19: yirra_docs/static/img/arm_bonding/Epoxy_injection_2.jpg]
Epoxy distribution through the internal channels


The internal channels ensure epoxy flows completely around the tube, creating a stronger bond than traditional surface application.

:::tip
Inject slowly and steadily. You'll see epoxy appear at the gap between the tube and socket when the cavity is full. Stop injecting at this point.
:::

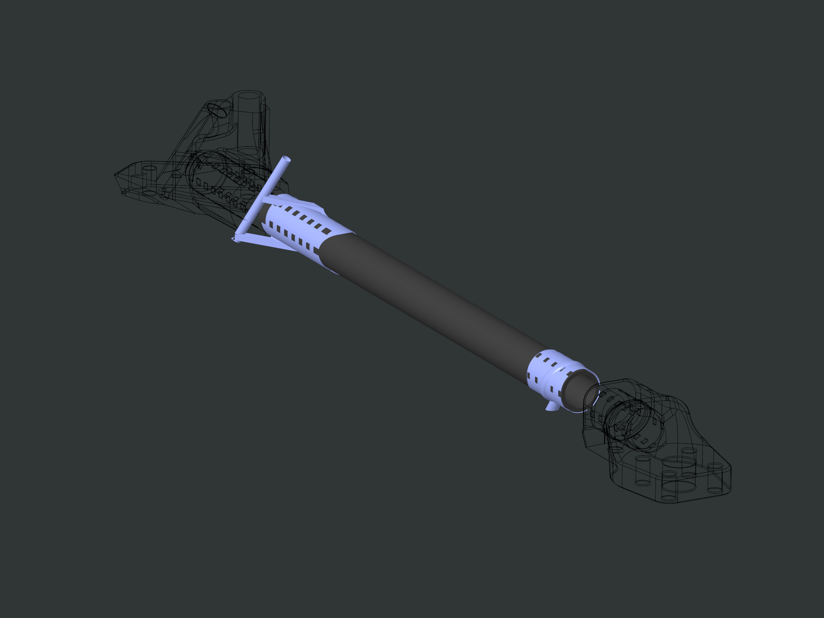
[picture p20: yirra_docs/static/img/arm_bonding/Explode_resin_interface.png]
Adhesive placement reference


---

### 4. Assemble In Order

1. Insert tube into **arm boss** first
2. Then insert other end into **motor mount**

Push until seated. Small amount of squeeze-out is normal.

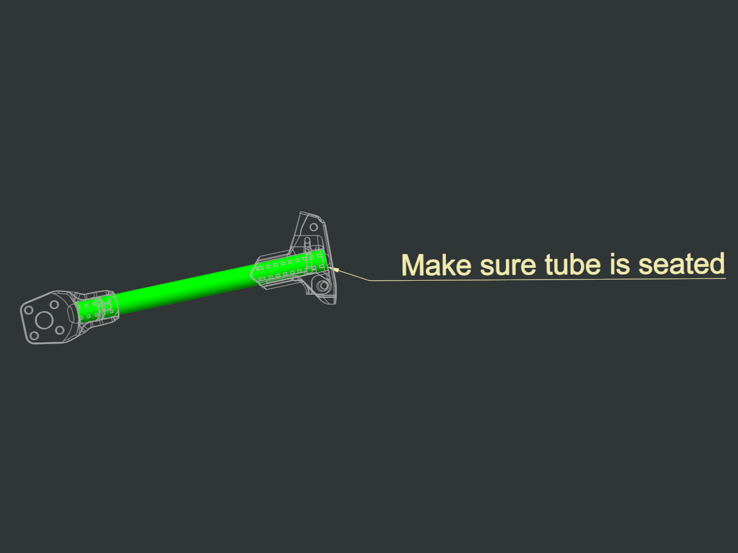
[picture p21: yirra_docs/static/img/arm_bonding/Tube seated annotation.png]
Carbon tube fully seated in the motor mount


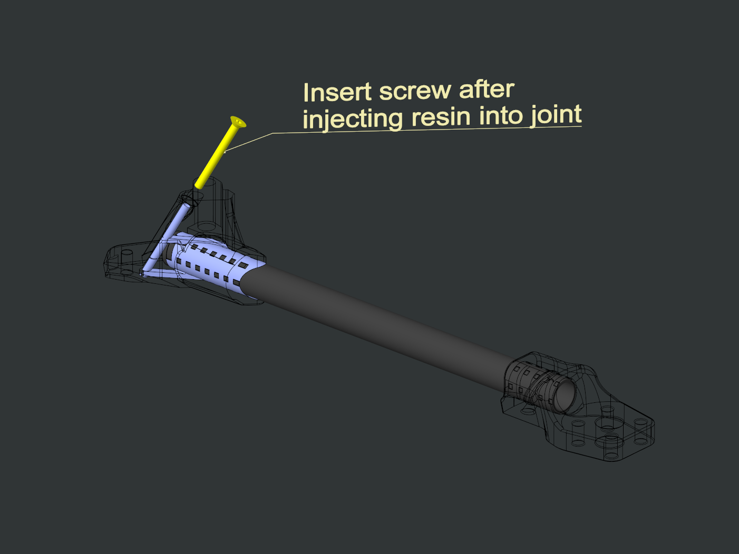
[picture p22: yirra_docs/static/img/arm_bonding/Screw_insertion.png]
Carbon tube insertion


---

### 5. Alignment Check

**Critical step.**

1. Place spacer under the arm boss end
2. Whole arm should sit **flat and planar**
3. Sight down the arm axis
4. Rotate until motor mount and arm boss are **in the same plane**

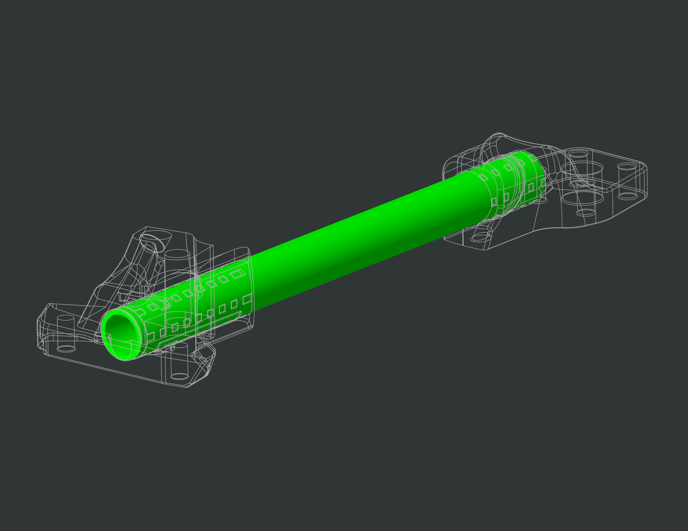
[picture p23: yirra_docs/static/img/arm_bonding/ISO_view not annotated.png]
Arm alignment reference


---

### 5. Clean Up Bleed Out

Remove any epoxy that has squeezed out from the joint using a clean cloth or paper towel while the epoxy is still wet. This prevents a messy appearance and ensures the joint is clean.

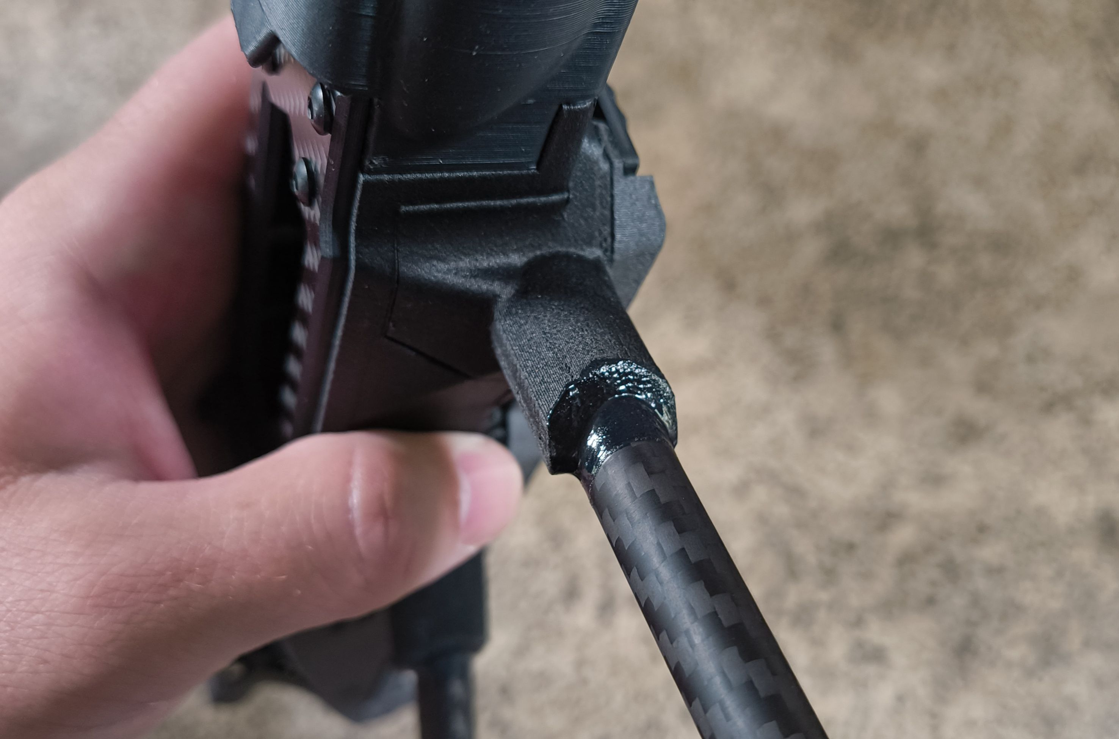
[picture p24: yirra_docs/static/img/arm_bonding/Bleed_out_clean_up.jpg]
Epoxy bleed out cleanup


---

### 6. Cure

- Lay flat, undisturbed
- **24 hours** minimum for full cure
- Recommended: do **two arms at a time**, not all four

---

## High Performance Motor Mounts

:::warning High performance motor mounts for critical applications

We offer the option of printing motor mounts with the high performance **Continuous Carbon Fiber** printing process provided by Markforged printers. This part can be up to **335% stronger** depending on the exact load case.

**Not all applications will require this level of safety factor.** Though if your drone is used in professional applications requiring elevated safety factors, this is a go-to upgrade.

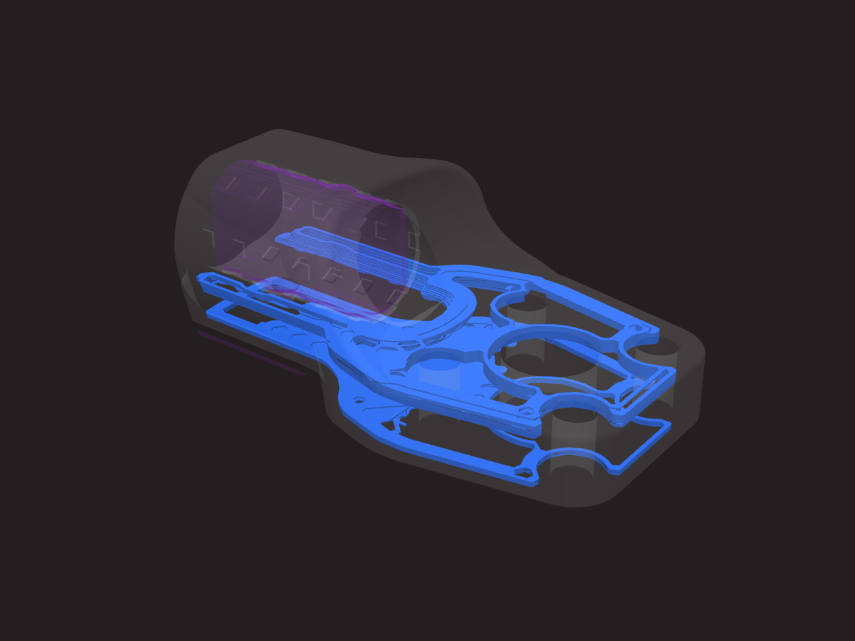
[picture p25: yirra_docs/static/img/arm_bonding/Critical_applications.png]
High performance motor mounts for critical applications

:::

---

## Acceptance Criteria

✅ No visible gaps at bond joints  
✅ Motor mount and arm boss are coplanar  
✅ Arm sits flat on surface (no twist)  
✅ Squeeze-out cleaned before cure

---

## Common Mistakes

| Mistake | Result |
|---|---|
| Arms not aligned | Motors not in plane, vibration issues |
| Too much epoxy | Messy, adds weight |
| Not enough epoxy | Weak bond, may fail |
| Moving before cure | Bond failure |
| Wet nylon parts | Weak adhesion |

---

## Next Steps

1. Allow 24 hours cure time
2. Proceed to [Assembly](/docs/assembly)
3. See [Firmware](/docs/inav) for iNav configuration
