fabrilabdesign/Yirra-docs/Email system/Readiness_Assessment.md

# Email System Readiness Assessment - Yirra Systems

## 📊 Current Status: NOT READY TO BUILD

**Date:** November 8, 2025
**Assessment:** Critical prerequisites missing

---

## 🚨 Critical Finding: Zoho Migration Required

### Current Email Setup
Your domain `yirrasystems.com` is currently configured to use **Zoho Mail**:

```
MX Records: mx.zoho.com (priority 10), mx2.zoho.com (20), mx3.zoho.com (50)
SPF Record: "v=spf1 include:zohomail.com -all"
A Record: mail.yirrasystems.com → Cloudflare IPs (104.21.86.170, 172.67.222.102)
```

### Required Changes
**BEFORE deploying your email system**, you need to:

1. **Migrate existing mailboxes** from Zoho to your new system
2. **Update MX records** to point to your mail server
3. **Update SPF record** for your mail server
4. **Add DKIM, DMARC, MTA-STS, TLS-RPT records**
5. **Configure PTR record** at your hosting provider

---

## ✅ What's Ready

### Infrastructure
- [x] **k3s cluster** running with control-plane node `lucy`
- [x] **Traefik ingress controller** configured
- [x] **cert-manager** with Let's Encrypt issuers
- [x] **local-path storage class** available
- [x] **email-system namespace** created

### Documentation
- [x] **Work Plan** with 6-engineer team structure and phased rollout
- [x] **Build Guide** with complete YAML configurations
- [x] **DNS Configuration Guide** with all required records
- [x] **DNS Quick Checklist** for validation
- [x] **DNS Validation Script** (`validate-dns.sh`)

---

## ❌ What's Missing

### DNS Configuration
- [ ] **MX Records:** Currently point to Zoho, need to change to your mail server
- [ ] **SPF Record:** Currently for Zoho, needs update for your IP
- [ ] **DKIM Records:** Missing - need to generate keys first
- [ ] **DMARC Records:** Missing - critical for deliverability
- [ ] **MTA-STS Records:** Missing - for TLS enforcement
- [ ] **TLS-RPT Records:** Missing - for delivery reporting
- [ ] **PTR Record:** Missing - reverse DNS at hosting provider

### Deployment Files
- [ ] **Complete YAML files:** Build guide is in diff format, need complete deployment files
- [ ] **ConfigMaps and Secrets:** Need to be created with actual values
- [ ] **DKIM key generation:** Need to generate and deploy DKIM keys

### Migration Planning
- [ ] **Zoho mailbox export:** Plan for migrating existing emails
- [ ] **Downtime coordination:** Schedule MX record change with minimal disruption
- [ ] **Rollback plan:** If issues occur, ability to revert to Zoho

---

## 🛠️ Recommended Next Steps

### Phase 1: Planning (1-2 days)
1. **Export Zoho mailboxes** to PST or other format
2. **Generate DKIM key pair** using build guide commands
3. **Create complete deployment YAMLs** from build guide patches
4. **Test deployment** in staging environment

### Phase 2: DNS Preparation (1 day)
1. **Add DKIM, DMARC, MTA-STS, TLS-RPT records** (don't change MX/SPF yet)
2. **Configure PTR record** at hosting provider
3. **Test DNS propagation** with validation script

### Phase 3: Deployment (2-3 days)
1. **Deploy email system** in `email-system` namespace
2. **Import mailboxes** from Zoho export
3. **Test internal functionality** thoroughly

### Phase 4: Migration (1 day)
1. **Update MX records** to point to your mail server
2. **Update SPF record** for your server IP
3. **Monitor delivery** and fix any issues
4. **Gradually ramp up DMARC** from `none` to `quarantine` to `reject`

---

## 🔄 Alternative Approach: Parallel Setup

Instead of immediate migration, consider:

1. **Deploy new email system** alongside Zoho
2. **Use different subdomain** (e.g., `mail-new.yirrasystems.com`) for testing
3. **Gradually migrate users** from Zoho to new system
4. **Keep Zoho as backup** during transition period

### Benefits:
- **Zero downtime** during migration
- **Ability to test thoroughly** before full switch
- **Easy rollback** if issues occur
- **Gradual user migration** reduces risk

### Implementation:
1. Deploy with temporary subdomain for testing
2. Migrate a few test accounts first
3. Full migration when confident
4. Decommission Zoho after successful transition

---

## 📋 Pre-Build Checklist

### Infrastructure Ready
- [x] k3s cluster operational
- [x] Traefik ingress working
- [x] cert-manager configured
- [x] Storage class available
- [x] email-system namespace created

### Documentation Ready
- [x] Work plan complete
- [x] Build guide available
- [x] DNS guides created
- [x] Validation tools ready

### DNS Prerequisites (ACTION REQUIRED)
- [ ] Zoho mailboxes exported
- [ ] DKIM keys generated
- [ ] PTR record configured
- [ ] Migration plan documented

### Deployment Prerequisites
- [ ] Complete YAML files created
- [ ] Secrets and ConfigMaps prepared
- [ ] Test deployment successful

---

## 🎯 Recommendation

**DO NOT BUILD YET** - You need to complete the DNS migration planning first.

**Suggested Timeline:**
- **Today:** Export Zoho data, plan migration approach
- **Tomorrow:** Generate DKIM keys, create deployment YAMLs
- **Day 3:** Test deployment with parallel setup
- **Day 4:** Execute migration during low-traffic period

**Rationale:** Email is business-critical. A failed migration could disrupt all company communications. The parallel setup approach minimizes risk.

---

## 📞 Questions to Answer

1. **How many Zoho mailboxes** need to be migrated?
2. **What's your tolerance** for email downtime?
3. **Do you have a low-traffic period** for the migration?
4. **Do you want parallel setup** or direct migration?
5. **What's your timeline** for completing the email system?

---

*Assessment completed by AI Assistant - November 8, 2025*
*Ready to proceed once DNS migration planning is complete*
