fabrilabdesign/Yirra-docs/yirra_docs/DEPLOYMENT_SUMMARY.md

# 🎉 Yirra Systems Documentation Site - Deployment Summary

## ✅ Deployment Status: SUCCESSFUL

The Docusaurus documentation site has been successfully deployed to your Kubernetes cluster!

---

## 📍 Access Information

- **Production URL**: `https://yirrasystems.com/docs`
- **Deployment**: `docs` in `drone-store` namespace
- **Pod Status**: Running (1/1 replicas)
- **Health**: All health checks passing

---

## 🎨 Features Implemented

### ✅ Brand Theming
- **Primary Color**: `#06b6d4` (Yirra cyan)
- **Signature Cyan**: `#00f2fe` 
- **Fonts**: Inter (body), Space Grotesk (headings)
- **Design**: Glassmorphism effects matching main site
- **Dark Mode**: Fully supported with custom colors

### ✅ Clerk Authentication
- **SSO Integration**: Shares sessions with main Yirra site
- **Sign In/Out**: Navbar buttons for authentication
- **User Profile**: UserButton with avatar and account options
- **Key Management**: Embedded at build time for security

### ✅ Kubernetes Integration
- **Port**: 4000 (no conflict with frontend:3000)
- **Service**: ClusterIP on port 4000
- **Ingress**: Routed via `/docs` path
- **Resources**: 100m/200m CPU, 128Mi/256Mi memory
- **Health Checks**: `/healthz` endpoint on port 4000

### ✅ Deployment Automation
- **Script**: `./quick-docs.sh` for rapid updates
- **Pattern**: Matches existing frontend/backend deployment style
- **Registry**: Uses local K8s registry at `localhost:5000`
- **Versioning**: Timestamp-based tags for each deployment

---

## 🚀 Deployment Architecture

```
User Request (https://yirrasystems.com/docs)
    ↓
Nginx Ingress Controller
    ↓ (path: /docs)
Docs Service (ClusterIP:4000)
    ↓
Docs Pod (Nginx:4000)
    ↓
Docusaurus Static Site
```

---

## 📦 Technology Stack

| Component | Technology | Version |
|---|---|---|
| Framework | Docusaurus | 3.9.1 |
| Language | TypeScript | Latest |
| Auth | Clerk React | Latest |
| Container | Nginx (unprivileged) | stable-alpine |
| Node | Node.js | 20-alpine |
| Orchestration | Kubernetes (K3s) | - |

---

## 📂 Project Structure

```
yirra_docs/
├── docs/                          # Documentation content
│   └── intro.md                   # Welcome page
├── blog/                          # Changelog entries
├── src/
│   ├── components/
│   │   ├── AuthButtons.tsx        # Clerk auth UI
│   │   └── AuthButtons.module.css # Auth styling
│   ├── css/
│   │   └── custom.css             # Yirra brand theme
│   └── theme/
│       ├── Root.tsx               # ClerkProvider wrapper
│       └── Navbar/
│           └── index.tsx          # Custom navbar with auth
├── static/                        # Static assets
├── Dockerfile                     # Multi-stage build (Node 20 + Nginx)
├── nginx.conf                     # Port 4000 configuration
├── docusaurus.config.ts           # Site configuration
├── k8s-deployment.yaml            # K8s deployment & service
├── k8s-ingress.yaml               # Ingress routing
├── quick-docs.sh                  # Automated deployment script
└── README.md                      # Project documentation
```

---

## 🛠️ Common Operations

### Update Documentation Content

1. Edit Markdown files in `docs/` directory
2. Run deployment:
   ```bash
   cd /home/james/yirra_systems_app/yirra_docs
   ./quick-docs.sh
   ```
3. Access at `https://yirrasystems.com/docs`

### Add New Documentation Pages

```markdown
---
sidebar_position: 2
---

# My New Page

Content here...
```

The page will automatically appear in the sidebar.

### Update Styling

Edit `src/css/custom.css` to modify colors, fonts, or layout.

### View Logs

```bash
# Real-time logs
kubectl logs -n drone-store -l app=docs -f

# Last 50 lines
kubectl logs -n drone-store -l app=docs --tail=50
```

### Check Status

```bash
# Pod status
kubectl get pods -n drone-store -l app=docs

# Service endpoints
kubectl get svc docs -n drone-store

# Ingress routing
kubectl get ingress docs-ingress -n drone-store
```

---

## 🔧 Configuration Files

### Environment Variables

- **CLERK_PUBLISHABLE_KEY**: Injected from K8s secret `clerk-secrets`
- Source: Shared with main Yirra site

### Kubernetes Resources

**Deployment**: `k8s-deployment.yaml`
- Replicas: 1
- Image: `localhost:5000/yirra-docs:latest`
- Port: 4000
- Health checks: `/healthz`

**Ingress**: `k8s-ingress.yaml`
- Path: `/docs(/|$)(.*)`
- Rewrite: Yes
- TLS: Shared certificate with main site

---

## 🎯 Next Steps

1. **Add Content**: Create documentation pages in `docs/` folder
2. **Organize Sidebar**: Edit `sidebars.ts` for navigation structure
3. **Create Categories**: Group related docs into categories
4. **Add Changelog**: Use `blog/` folder for version updates
5. **Customize Theme**: Further refine colors in `custom.css`
6. **Add Search**: Configure Algolia DocSearch (optional)
7. **Version Docs**: Enable versioning for multiple releases

---

## 📚 Resources

- **Docusaurus Docs**: https://docusaurus.io/
- **Clerk React Guide**: https://clerk.com/docs/quickstarts/react
- **Project README**: `/home/james/yirra_systems_app/yirra_docs/README.md`
- **Main Site**: https://yirrasystems.com

---

## ✨ Highlights

- ✅ **100% Brand Matched**: Cyan theme, glassmorphism, custom fonts
- ✅ **Secure Auth**: Clerk SSO with shared sessions
- ✅ **Production Ready**: K8s deployment with health checks
- ✅ **Easy Updates**: One-command deployment script
- ✅ **Fully Responsive**: Mobile-first design
- ✅ **TypeScript**: Full type safety
- ✅ **SEO Optimized**: Docusaurus best practices

---

**🚀 The documentation site is live and ready for content!**

Access it now at: https://yirrasystems.com/docs

For questions or issues, refer to the README.md in this directory.
