fabrilabdesign/Yirra-docs/yirra_docs/static/files/3d-printing/stl/motor_mounts.stl

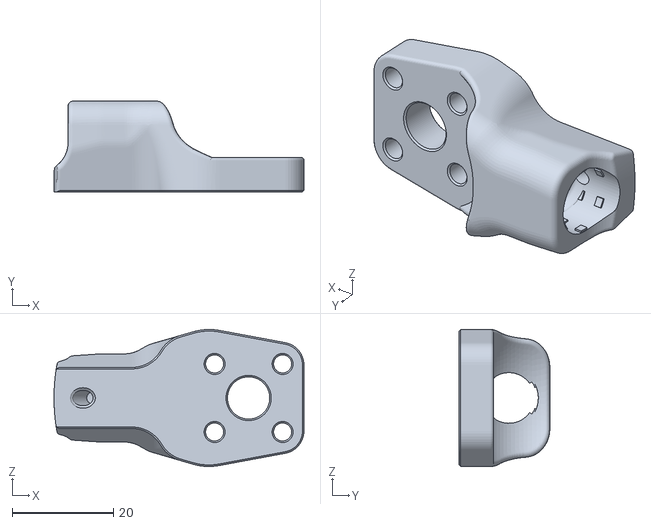
[picture p35: CAD file, 2026-01-22]
yirra_docs/static/files/3d-printing/stl/motor_mounts.stl
49.4 x 17.9 x 27.1
