fabrilabdesign/Yirra-docs/yirra_docs/static/files/STEP_Files/upper_shell.stp

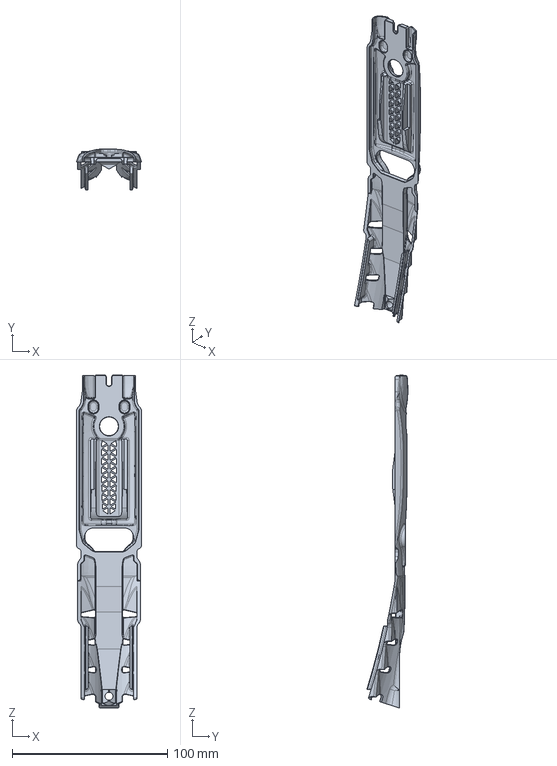
[picture p36: CAD file, 2026-02-02]
yirra_docs/static/files/STEP_Files/upper_shell.stp
41.9 x 26.6 x 214.6 mm
