fabrilabdesign/Yirra-docs/yirra_docs/static/img/tools/cj2.stp

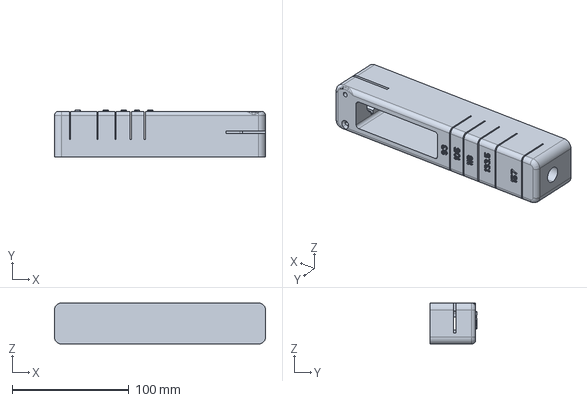
[picture p37: CAD file, 2026-02-05]
yirra_docs/static/img/tools/cj2.stp
180.6 x 40.0 x 35.0 mm
