fabrilabdesign/Yirra-docs/yirra_docs/static/files/3d-printing/stl/chassis_core_left_usb.stl

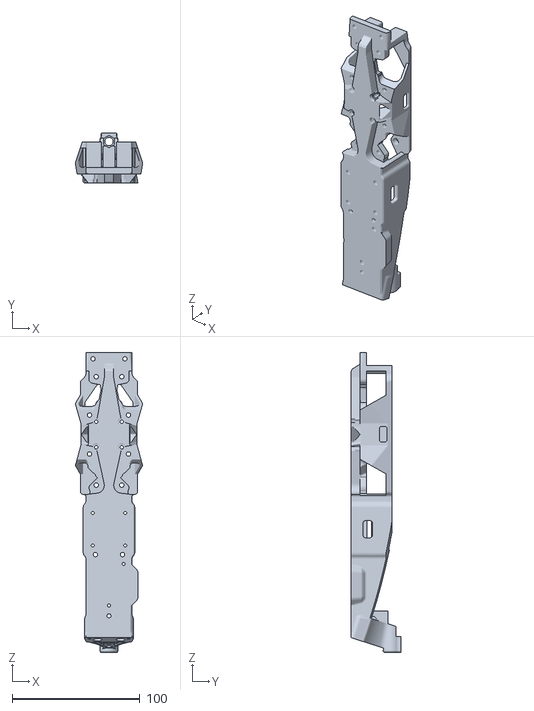
[picture p38: CAD file, 2026-01-22]
yirra_docs/static/files/3d-printing/stl/chassis_core_left_usb.stl
52.8 x 39.0 x 235.1
