fabrilabdesign/Yirra-docs/yirra_docs/static/files/STEP_Files/04cm.stp

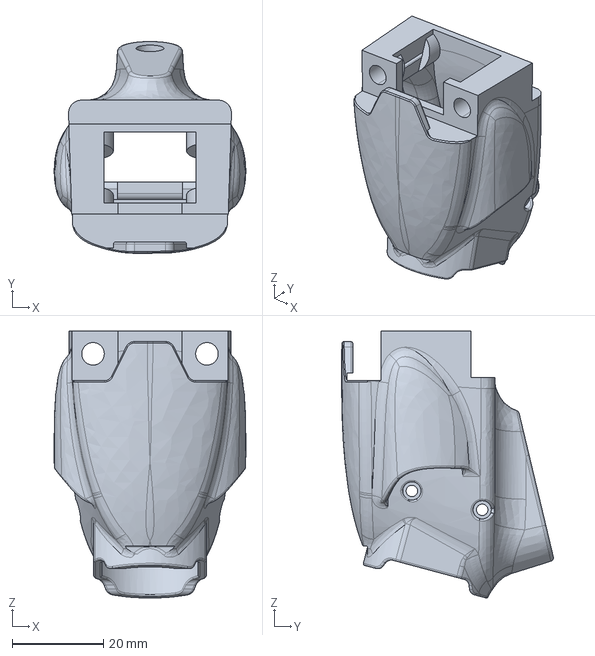
[picture p39: CAD file, 2026-01-22]
yirra_docs/static/files/STEP_Files/04cm.stp
42.1 x 46.6 x 58.7 mm
