fabrilabdesign/Yirra-docs/yirra_docs/static/files/STEP_Files/right_front_arm_boss.stp

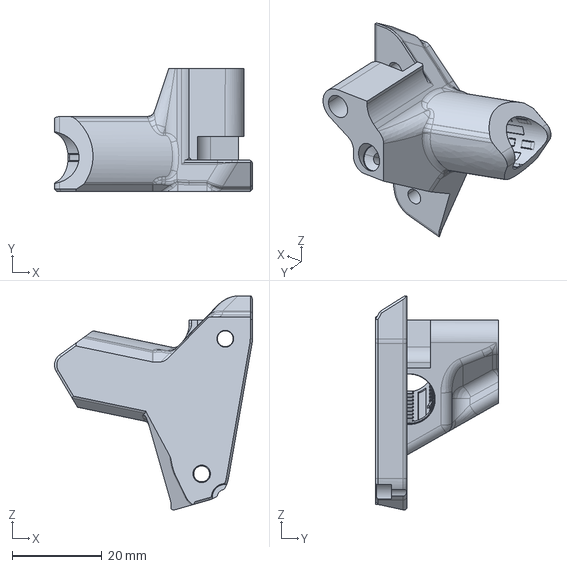
[picture p40: CAD file, 2026-01-22]
yirra_docs/static/files/STEP_Files/right_front_arm_boss.stp
44.0 x 27.3 x 47.6 mm
