fabrilabdesign/Yirra-docs/yirra_docs/static/files/STEP_Files/top_plate_brace.stp

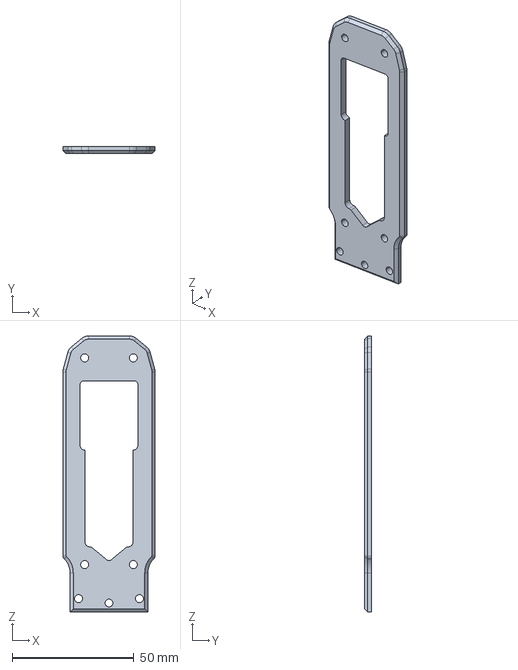
[picture p41: CAD file, 2026-01-22]
yirra_docs/static/files/STEP_Files/top_plate_brace.stp
38.0 x 3.00 x 113.5 mm
