fabrilabdesign/Yirra-docs/yirra_docs/static/files/STEP_Files/bottom_plate.stp

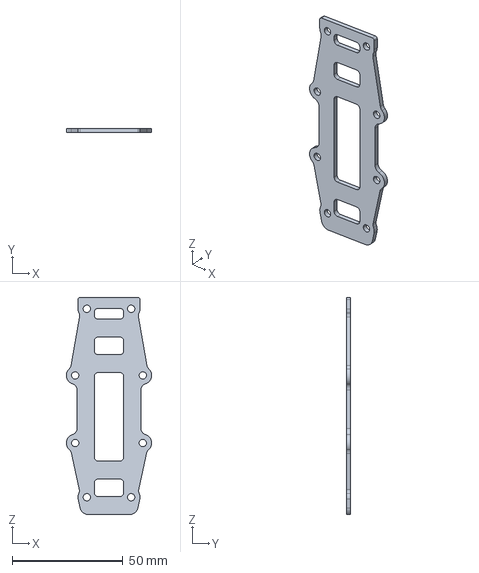
[picture p42: CAD file, 2026-01-22]
yirra_docs/static/files/STEP_Files/bottom_plate.stp
38.5 x 2.00 x 97.9 mm
