fabrilabdesign/Yirra-docs/yirra_docs/static/files/STEP_Files/battery_rail_male.stp

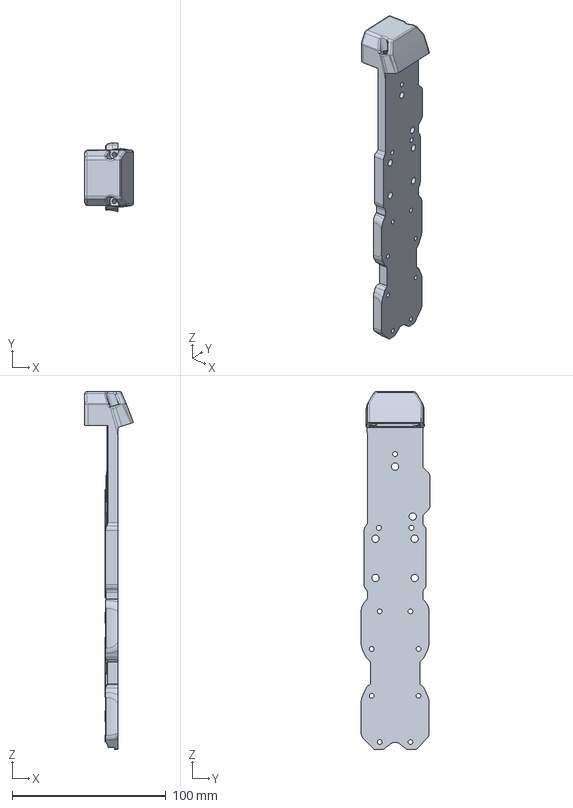
[picture p43: CAD file, 2026-01-22]
yirra_docs/static/files/STEP_Files/battery_rail_male.stp
31.8 x 44.8 x 233.0 mm
