fabrilabdesign/Yirra-docs/yirra_docs/static/files/STEP_Files/spine.stp

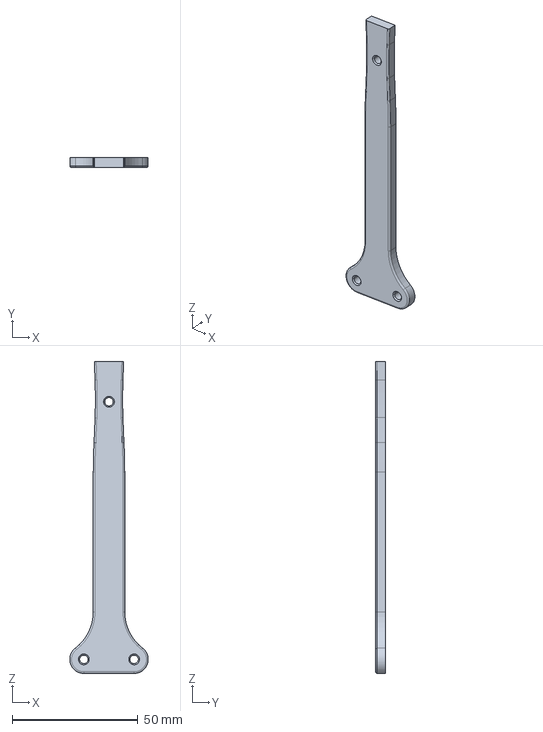
[picture p44: CAD file, 2026-01-22]
yirra_docs/static/files/STEP_Files/spine.stp
31.2 x 4.00 x 124.0 mm
