fabrilabdesign/Yirra-docs/yirra_docs/static/files/STEP_Files/Right_rear_arm_boss.stp

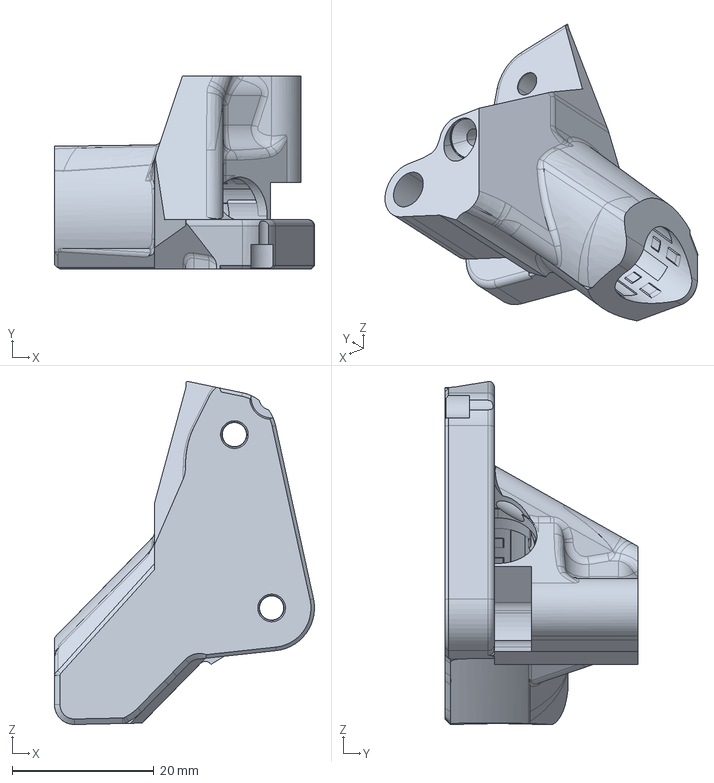
[picture p45: CAD file, 2026-01-22]
yirra_docs/static/files/STEP_Files/Right_rear_arm_boss.stp
36.7 x 27.3 x 48.4 mm
