fabrilabdesign/Yirra-docs/(list of files, cad)

Other CAD files:
yirra_docs/static/files/3d-printing/3mf/Chassis_core_left_USB_modi.gcode.3mf
yirra_docs/static/files/3d-printing/3mf/Arm_bosses.gcode.3mf
yirra_docs/static/files/3d-printing/3mf/Nose_cone_04_mount.gcode.3mf
yirra_docs/static/files/3d-printing/stl/chassis_core_right_usb.stl
yirra_docs/static/files/3d-printing/3mf/Battery_rail_male.gcode.3mf
yirra_docs/static/files/3d-printing/3mf/Motor_mounts.gcode.3mf
yirra_docs/static/files/STEP_Files/left_rear_arm_boss.stp
yirra_docs/static/files/STEP_Files/Motor_mount.stp
yirra_docs/static/files/STEP_Files/Left_front_arm_boss.stp
yirra_docs/static/files/3d-printing/stl/battery_rail_male.stl
yirra_docs/static/files/3d-printing/stl/bottom_plate.stl
yirra_docs/static/files/3d-printing/stl/left_front_armboss.stl
yirra_docs/static/files/3d-printing/stl/left_rear_arm_boss.stl
yirra_docs/static/files/3d-printing/stl/right_front_arm_boss.stl
yirra_docs/static/files/3d-printing/stl/right_rear_arm_boss.stl
yirra_docs/static/files/3d-printing/stl/spine.stl
yirra_docs/static/files/3d-printing/stl/top_plate_brace.stl
yirra_docs/static/files/3d-printing/stl/upper_shell.stl
