fabrilabdesign/Yirra-docs/test-results-summary.md

# Magic Sauce App - Test Results Summary

## Test Execution: 2025-11-01

### **CRITICAL ISSUES FOUND** 🚨

## Problem Analysis

The application has **significant routing and service issues**:

### ✅ Working
- **Frontend**: React SPA loads correctly at root URL
- **Basic Health**: `/health` endpoint returns JSON (but may be frontend-served)

### ❌ Broken/Missing
- **Backend API**: Most API endpoints return HTML (React app) instead of JSON
- **Backend Service**: Appears to be down or not accessible
- **Ready Endpoint**: `/ready` times out completely
- **API Routes**: `/test`, `/auth/status`, `/users`, etc. all return frontend HTML

### Root Cause Analysis

1. **Backend Service Down**: The Fastify backend appears to be crashed or not running
2. **Proxy Misconfiguration**: All API routes are falling through to frontend
3. **Service Discovery**: Backend not accessible via expected paths

### Evidence from Tests

**Working endpoint:**
```bash
curl https://magic-sauce.addiaire.com/health
# Returns: {"ok":true,"timestamp":"2025-11-01T08:01:33.360Z"}
```

**Broken endpoints (all return HTML):**
```bash
curl https://magic-sauce.addiaire.com/test          # Returns React HTML
curl https://magic-sauce.addiaire.com/auth/status   # Returns React HTML  
curl https://magic-sauce.addiaire.com/users         # Returns React HTML
curl https://magic-sauce.addiaire.com/ready         # Times out
```

## Recommendations

### Immediate Actions Required:
1. **Check Backend Service Status** - Verify if backend pods are running
2. **Review Proxy Configuration** - Fix routing between frontend and backend
3. **Check Backend Logs** - Identify why backend crashed/stopped
4. **Verify Service Networking** - Ensure backend is accessible

### Test Results Summary:
- **Connectivity**: ✅ Basic HTTP works
- **Frontend**: ✅ Loads correctly  
- **Backend API**: ❌ Not accessible
- **Load Testing**: ⚠️ Skipped (Artillery not installed)
- **Overall Status**: 🚫 **SYSTEM DOWN** - Backend service unavailable

---
*Test completed at: 2025-11-01 08:01 UTC*
