fabrilabdesign/Yirra-docs/yirra_docs/k8s-deployment.yaml

apiVersion: apps/v1
kind: Deployment
metadata:
  name: docs
  namespace: drone-store
  labels:
    app: docs
spec:
  replicas: 1
  selector:
    matchLabels:
      app: docs
  template:
    metadata:
      labels:
        app: docs
    spec:
      containers:
      - name: docs
        image: localhost:5000/yirra-docs:v2-assembly
        ports:
        - containerPort: 4000
          name: http
          protocol: TCP
        env:
        - name: CLERK_PUBLISHABLE_KEY
          valueFrom:
            secretKeyRef:
              name: clerk-secrets
              key: CLERK_PUBLISHABLE_KEY
        resources:
          requests:
            cpu: 100m
            memory: 128Mi
          limits:
            cpu: 200m
            memory: 256Mi
        livenessProbe:
          httpGet:
            path: /healthz
            port: 4000
          initialDelaySeconds: 10
          periodSeconds: 30
          timeoutSeconds: 5
        readinessProbe:
          httpGet:
            path: /healthz
            port: 4000
          initialDelaySeconds: 5
          periodSeconds: 10
          timeoutSeconds: 3
      imagePullSecrets:
      - name: regcred
---
apiVersion: v1
kind: Service
metadata:
  name: docs
  namespace: drone-store
  labels:
    app: docs
spec:
  type: ClusterIP
  ports:
  - port: 4000
    targetPort: 4000
    protocol: TCP
    name: http
  selector:
    app: docs
