fabrilabdesign/Yirra-docs/monitoring/uptime-kuma.yaml

kind: Namespace
apiVersion: v1
metadata:
  name: monitoring
---
apiVersion: v1
kind: Service
metadata:
  name: uptime-kuma-service
  namespace: monitoring
spec:
  selector:
    app: uptime-kuma
  ports:
  - name: http
    port: 3001
    targetPort: 3001
---
apiVersion: apps/v1
kind: StatefulSet
metadata:
  name: uptime-kuma
  namespace: monitoring
spec:
  replicas: 1
  serviceName: uptime-kuma-service
  selector:
    matchLabels:
      app: uptime-kuma
  template:
    metadata:
      labels:
        app: uptime-kuma
    spec:
      containers:
        - name: uptime-kuma
          image: louislam/uptime-kuma:1.23.13
          ports:
            - containerPort: 3001
              name: http
          volumeMounts:
            - name: data
              mountPath: /app/data
          resources:
            requests:
              cpu: 100m
              memory: 128Mi
            limits:
              cpu: 500m
              memory: 512Mi
          livenessProbe:
            httpGet:
              path: /
              port: 3001
            initialDelaySeconds: 30
            periodSeconds: 10
          readinessProbe:
            httpGet:
              path: /
              port: 3001
            initialDelaySeconds: 30
            periodSeconds: 10
  volumeClaimTemplates:
    - metadata:
        name: data
      spec:
        accessModes:
          - ReadWriteOnce
        resources:
          requests:
            storage: 1Gi
---
apiVersion: networking.k8s.io/v1
kind: Ingress
metadata:
  name: uptime-kuma-ingress
  namespace: monitoring
spec:
  ingressClassName: traefik
  rules:
  - host: kuma.yirrasystems.com
    http:
      paths:
      - path: /
        pathType: Prefix
        backend:
          service:
            name: uptime-kuma-service
            port:
              number: 3001
