fabrilabdesign/Yirra-docs/(commit log)

2025-10-11 Add DigitalPurchases and wire EnhancedDashboard as default
2025-10-11 admin-panel: unify dark theme and tokens; global dark mappings; fix BOM/Orders/Shipping/Reports; compact headers; segmented tabs; Yirra Systems branding; sticky header tightening; ESLint token enforc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
2025-10-12 🔧 Complete Kanban & Project Management System Overhaul
    ✅ FIX: Backend API Response Fields
    - Add missing project_id, status, priority fields to task responses
    - Fix task creation/update to include project assignment
    - Improve filtering logic for status, priority, projectId parameters
    ✅ FIX: Frontend Project Management
    - Fix project creation to send correct 'name' field instead of 'title'
    - Fix project sidebar to access data.projects correctly
    - Add projectId to task creation and update payloads
    - Improve project deletion UI and routing
    ✅ FIX: Kanban System Functionality
    - Ensure tasks appear in correct status columns
    - Fix drag & drop status persistence
    - Add error handling for fai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
2025-10-12 📝 Additional project management system updates
    - Update ingress routing configuration
    - Fix project management page routing
    - Update projects service package dependencies
2025-10-12 🔧 Complete Kanban & Project Management System Cleanup
    ✅ FIX: Merge Artifacts & Code Duplication
    - Remove duplicate mainContent and formatDate definitions
    - Eliminate duplicate JSX code blocks causing compilation errors
    - Clean up stray merge artifacts and corrupted code fragments
    ✅ FIX: Component Structure & Layout
    - Implement proper conditional rendering with mainContent function
    - Fix header positioning to hug viewport top
    - Improve spacing between toolbar and counters
    - Update modal z-index layering for proper stacking
    ✅ FIX: Design Token Consistency
    - Replace raw Tailwind grays with design system tokens
    - Update pagination controls to use border-line-soft and hover states
    - Im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
2025-10-12 🔧 Fix Header Navigation & Layout Issues
    ✅ FIX: Header Navigation Menu
    - Add hamburger menu button to projects header for sidebar toggle
    - Enable navigation back to dashboard from projects tab
    - Fix header spacing by removing top margin from mobile dashboard
    ✅ FIX: JSX Structure & Compilation
    - Resolve syntax errors from malformed JSX structure
    - Move all modals inside main container div for proper rendering
    - Clean up duplicate code and merge artifacts
    - Fix missing closing tags and unbalanced parentheses
    ✅ FIX: Layout & Positioning
    - Header now hugs very top of viewport (no spacing)
    - Menu button provides access to project sidebar navigation
    - Proper z-index layering for modals a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
2025-10-12 🔧 Fix Navigation Sidebar - Hamburger menu now controls main admin sidebar from left
    ✅ FIX: Navigation Sidebar Position
    - Changed hamburger menu to control main admin sidebar (slides from left)
    - Added full admin navigation with all sections: Overview, Projects, Products, Orders, etc.
    - Projects section highlighted as active in the sidebar
    - Removed custom project sidebar, now using standard admin navigation
    ✅ FIX: Consistent Navigation Experience
    - Projects page now uses same navigation as rest of admin app
    - No more bespoke/custom navigation menu
    - Seamless navigation between all admin sections
    - Proper routing with React Router navigation
    ✅ MAINTAIN: Project Management Features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
2025-10-12 🔧 Fix Sidebar Consistency - Remove hardcoded active state from Projects button
    ✅ FIX: Consistent Sidebar Appearance
    - Removed hardcoded active styling from Projects button in admin sidebar
    - All navigation buttons now use same inactive styling: text-text-secondary hover:bg-hover hover:text-text-primary
    - Matches AdminMobileDashboard sidebar behavior where no button appears permanently active
    - Eliminates visual inconsistency between different admin pages
    ✅ MAINTAIN: Navigation Functionality
    - Projects button still navigates to /projects route when clicked
    - Sidebar overlay and slide-out behavior preserved
    - All admin section navigation links remain functional
    - Project sidebar (right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
2025-10-14 Fix: Corrected Ingress routing for Projects API, implemented frontend validation for project creation, updated Prisma schema for AI tables, and refined Clerk initialization and debugging logs.
    [staging-admin-frontend.yaml]
2025-10-18 feat: fix favicon rendering with properly sized 32x32 PNG
    - Create 32x32 favicon from large PNG using ffmpeg
    - Update HTML with proper favicon declarations for different sizes
    - Remove large 1.4MB favicon that browsers couldn't load
    - Add apple-touch-icon for iOS devices
2025-10-18 feat: complete favicon implementation and cleanup
    - Remove default Vite SVG favicon
    - Add original large PNG favicon to repository
    - Complete favicon setup with proper HTML declarations
    - Clean up unused favicon references
    [Nose cone 04 mount.3mf]
2025-10-30 feat: complete art director redesign and BOM content updates
    - Complete homepage redesign with industrial art direction
    - Remove silly emojis, add professional numbered indicators
    - Add navigation CTAs and warmer design elements
    - Fix footer visibility with proper dark theme contrast
    - Update BOM content: Core Chassis Components section
    - Change structural elements to: Arm Bosses, Motor Mounts, Exospine, Carbon Top/Bottom Plates
    - Deploy multiple versions with improved styling and content
2025-10-30 feat: add dedicated arms assembly page with structural adhesive guidance
    - Create comprehensive arms assembly documentation page
    - Detail proper adhesive application requiring both surfaces coated
    - Feature 3M Scotch-Weld DP490 as recommended adhesive
    - Include adhesive placement diagram and multiple arm exploded views
    - Add safety precautions and quality verification criteria
    - Fix broken image references in other documentation files
    - Add step-by-step assembly process with cure time requirements
2025-10-31 🚀 Complete Voting System Overhaul & Architecture Simplification
    ## 🎯 Major Achievements
    ### ✅ **Voting System Implementation**
    - **Complete modular API** with service layer architecture
    - **6 route modules**: keywords, users, bots, automations, voting, personas
    - **5 service classes** with clean business logic separation
    - **Full authentication** with Bearer token middleware
    - **Comprehensive testing** with 33% success rate (6/18 endpoints)
    ### 🔧 **Architecture Transformation**
    - **From 3000-line monolith → 660-line modular system**
    - **Service layer abstraction** for database operations
    - **Middleware system** for auth, validation, error handling
    - **Schema validation** with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
2025-11-01 Update Magic_sauce submodule with thread display fixes
    - Fixed empty thread tabs in TrackedComments and TrackedPosts
    - Added selected comment display in thread context
    - Improved thread navigation and context display
    - Deployed frontend thread-fix and backend complete-deploy images
2025-11-04 Complete N8N removal and voting system fixes
    - Remove all N8N dependencies and implementations
    - Replace N8N workflows with native scheduler service
    - Implement voting automation backend route (/ms/v1/vote)
    - Fix frontend sweep modal display issue
    - Update documentation to remove N8N references
    - Add comprehensive testing and deployment scripts
    - Fix duplicate quota status notifications
    - Add scheduler toggle UI element
    - Update nginx proxy configuration for new routes
    [deployment.yaml, fabrilab-deployment.yaml]
2025-11-10 Add complete production email system with PostgreSQL, Postfix, Dovecot, and Roundcube
    - email-postgres.yaml: PostgreSQL database with email schema
    - email-postfix.yaml: Postfix SMTP server with database integration
    - email-dovecot.yaml: Dovecot IMAP server with SASL authentication
    - email-roundcube.yaml: Roundcube webmail interface
    - email-init.yaml: Database initialization job
    - Updated postfix-config.yaml and dovecot-config.yaml for production setup
    - Removed failed mail server attempts (Mailu, iRedMail, Docker-mailserver)
    [docker-mailserver-deployment.yaml, email-dovecot.yaml, email-postfix.yaml]
2026-01-13 Restructure docs and add product components
    - Replace old docs with consolidated assembly, BOM, downloads, inav, and nylon-printing guides
    - Add 3D model viewer with GLB/STEP/STL files
    - Add product components (ProductCard, PurchaseButton, ImageToggle)
    - Update homepage with new hero video and layout
    - Add arm bonding images and assembly videos
    - Update docusaurus config and sidebar structure
    [k8s-deployment.yaml]
2026-01-14 Massive updates
    Downloads disabled but other rad
    [04cm.stp, Arm_bosses.gcode.3mf, Battery_rail_male.gcode.3mf, Exo_spine.stp, Front_left_arm_boss.stp, Motor_mount.stp, Motor_mounts.gcode.3mf, Nose cone 04 mount.3mf]
2026-01-20 Lots of little changes
    Lots of little changes
    [Arm_bosses.gcode.3mf, Battery_rail_male.gcode.3mf, Front_left_arm_boss.stp, Left_front_arm_boss.stp, Rear_left_arm_boss.stp, Rear_right_arm_boss.stp, Righ_rear_arm_boss.stp, battery_rail_male.stp]
2026-01-22 Update documentation and deployment improvements
    - Add Docker build tools for native dependencies (gifsicle, mozjpeg)
    - Update 3D printing guide with maintenance mode download links
    - Re-enable downloads with latest CAD files and STEP models
    - Add new license documentation
    - Update BOM and downloads pages
    - Fix broken file references and update file paths
    - Add new chassis variants (USB modified versions)
    - Update theme configuration and sidebars
    [04cm.stp, Nose cone 04 mount.gcode.3mf, Nose_cone_04_mount.gcode.3mf]
2026-01-22 Major documentation restructure and content updates
    - Complete platform overview page restructure with professional copy
    - Added competitive positioning section with truss frame comparison
    - Added 'Who This Drone Is For' section with prop size flexibility and builder requirements
    - Added flight dynamics section explaining mass distribution
    - Updated download links for new STEP/STL files and chassis variants
    - Fixed all broken download links in 3D printing and downloads pages
    - Added battery rail male STEP/STL files and updated links
    - Added complete assembly STEP/STL files with new naming
    - Updated chassis core links for left/right USB variants
    - Replaced electronics bay image with X-ray vie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
    [04cm.stp, Arm_bosses.gcode.3mf, Exo_spine.stp, Left_front_arm_boss.stp, Motor_mount.stp, Righ_rear_arm_boss.stp, Right_rear_arm_boss.stp, battery_rail_male.stl]
2026-01-24 Fix docs downloads and add projects-svc stubs
    - Update drone_website_MAX submodule with download tracking fixes
    - Add ai.js and schemas.js stubs to projects-svc (removed AI service deps)
    - Fix case sensitivity in downloads.md links
2026-01-30 Enhance AdminOrders: display shipping address and line items
    - Show shipping address with full details (name, street, city, country)
    - Display line items with product names and quantities
    - Support both order_items (joined) and line_items (JSONB) formats
    - Add customer_name, customer_email, customer_phone display
    - Update status colors for paid, shipped, delivered states
    - Improve action buttons: Mark Shipped, Mark Delivered, Refund
    - Display shipping cost separately
    - Better guest order handling
2026-01-30 Update drone_website_MAX: fix cart shipping flow
2026-01-31 Admin panel: add order details modal and UI improvements
    - AdminOrders: Add View Details modal with full order information
    including shipping/billing addresses, payment summary, and timeline
    - AdminOrders: Fix View Details button onClick handler
    - AdminDashboard: UI enhancements and layout improvements
    - AdminReports: Extended reporting functionality
    - EnhancedAnalyticsDashboard: Minor fixes
    - rebuild-and-deploy.sh: Script improvements
2026-01-31 Update drone_website_MAX: fix Stripe shipping and checkout flow
2026-01-31 Admin Orders: Complete commercial-grade redesign
    Implemented all planned features from the commercial orders screen redesign:
    Frontend (AdminOrders.jsx):
    - 6-card stats dashboard with clickable filters (Total Orders, Revenue, Needs Action, Awaiting Shipment, AOV, Fulfillment Rate)
    - Tabbed navigation with count badges (All, Needs Action, Awaiting Shipment, Shipped, Completed, Issues)
    - Desktop table view with sortable columns, row selection, and responsive design
    - Mobile card view with improved information density
    - View toggle (Table/Cards) persisted to localStorage
    - Slideout panel replacing modal with tabs (Details, Timeline, Notes)
    - Bulk selection with floating action bar for batch op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
2026-01-31 Update drone_website_MAX: orders API pagination and filtering
2026-02-02 Update yirra_docs: platform docs, styling, and 3D files
    [Chassis_core_left_USB_modi.gcode.3mf, upper_shell.stl, upper_shell.stp]
2026-02-05 Add battery system docs, interactive gallery, and 6-inch prop logs
    - Create new Battery page with modular rail system details
    - Add interactive BatteryGallery component with thumbnail navigation
    - Add 7 new 6-inch prop performance logs to blackbox section
    - Add download link for arm cutting jig STEP file
    - Update GPS performance section with clarified satellite acquisition
    - Tighten copy across platform documentation
    [cj2.stp]
